MarkGilliland/benchBuddy/README.md

# benchBuddy
Code, schematics, and board layouts for the benchBuddy concept.

The benchBuddy is an adjustable power supply, DAQ unit, digital I/O source, and function generator! Just the thing for your workbench - your new buddy

Mark Gilliland 2019
