MarkGilliland/benchBuddy/eagle/facelate.pdf

GND | GND 3.3V | 5V | 0-10V 12V | FGEN
3.3V | 5V | 12V
VOLT | AMP
- | + | - | + VOLTS | AMPS | SET | ACTUAL METER USB | MANUAL | 0⁻10V | GNDON | OFF

0V

10V | 1.0A

0.0A
