MarkGilliland/benchBuddy/eagle/vectorCut.pdf

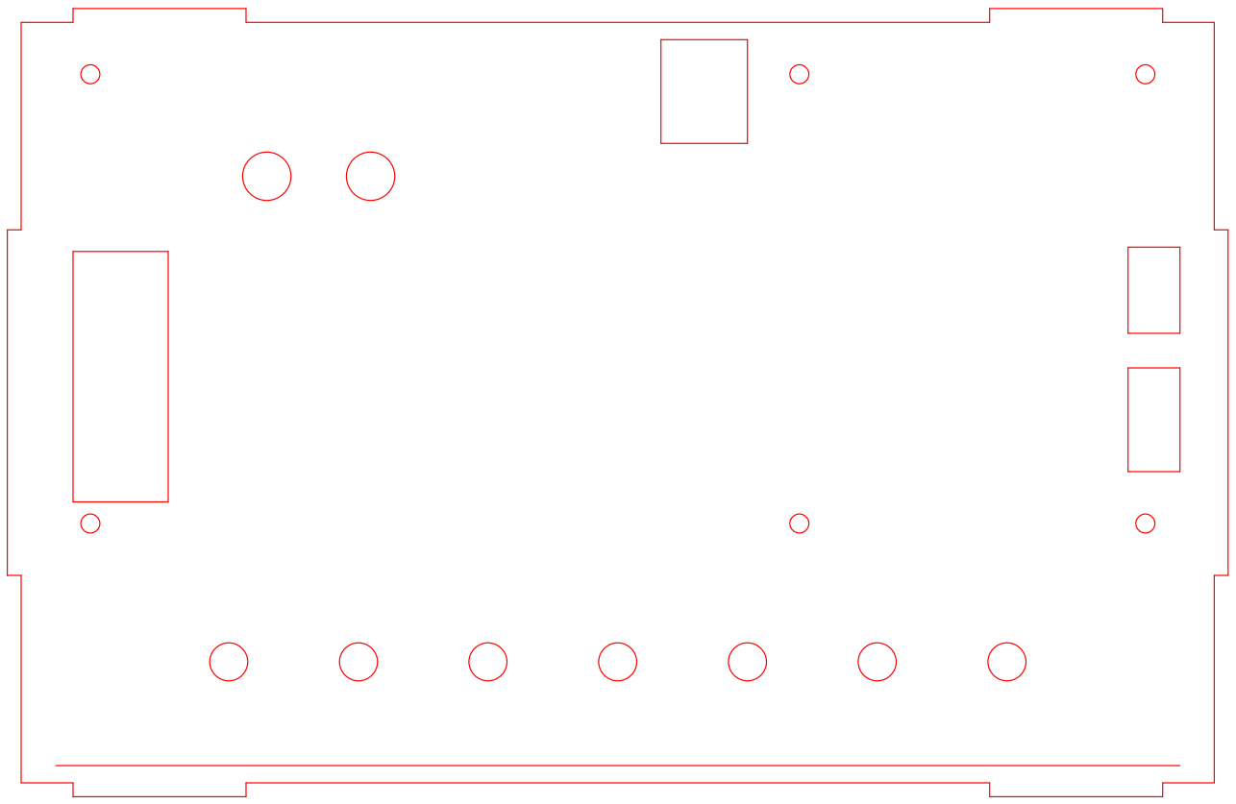
[picture p1: figure]
