MarkGilliland/benchBuddy/eagle/powerSupplyBoard.png

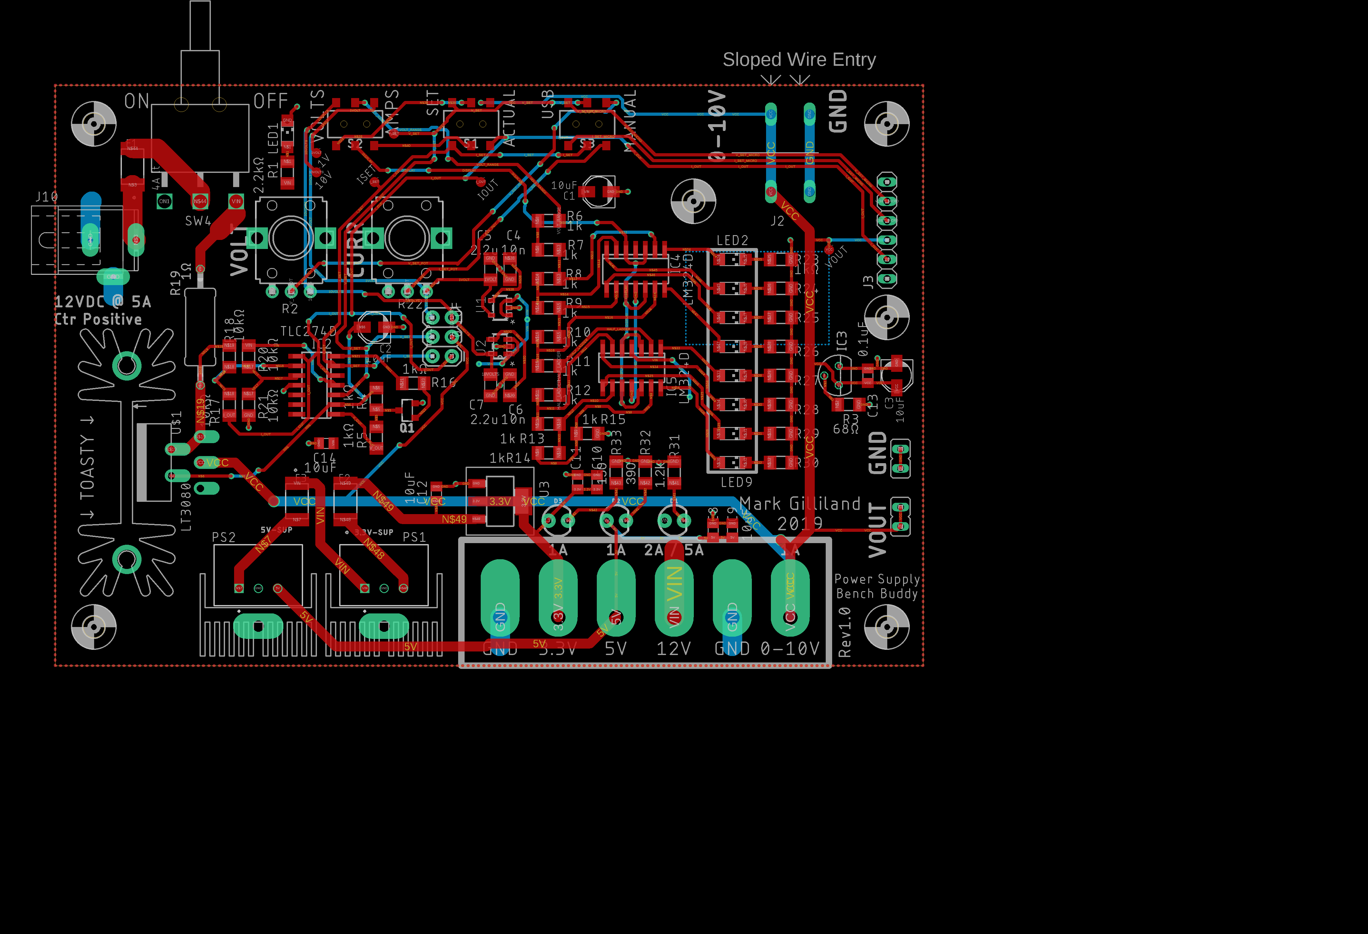
eagle/powerSupplyBoard.png
