MarkGilliland/benchBuddy/mating_header.png

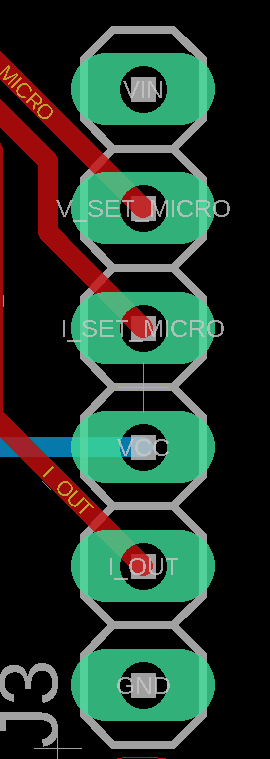
mating_header.png
