MarkGilliland/benchBuddy/microBackpack/microBackpack.png

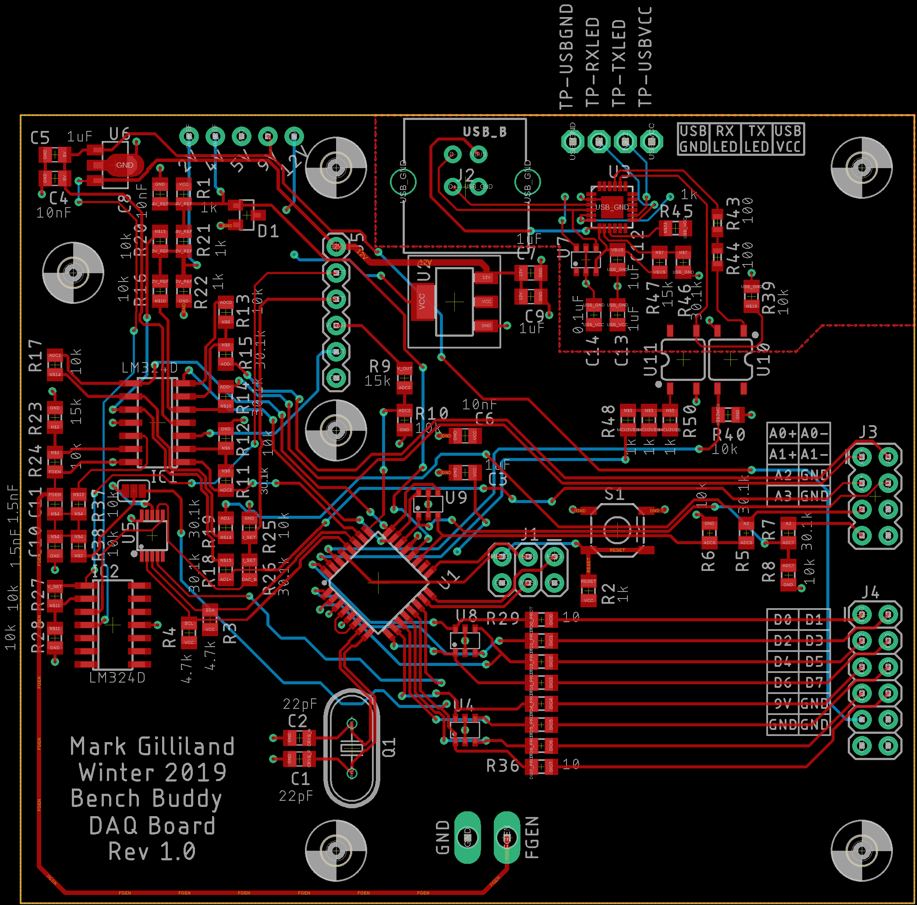
microBackpack/microBackpack.png
