MarkGilliland/benchBuddy/BOM_Initial.xlsx

Sheet: PurchaseBOM
Usage | Component Type | RefDes | Value | Package | Description | Part Number 1 | Part Number 2 | Link | Qty Required | Order Qty | Price Per | Price | Board | Part List
Crystal Capacitors | Passive, Capacitor | C1, C2 | 22pF | C0805 | CAP CER 22PF 16V C0G/NP0 0805 | 732-7816-1-ND |  | 732-7816-1-ND | 2 | 10 | $0.04 | $0.09 | MBP | MBP-C1, C2
FGen Filter Caps | Passive, Capacitor | C10, C11 | 1.5nF | C0805 | CAP CER 1500PF 25V NP0 0805 | 732-12256-1-ND |  | 732-12256-1-ND | 2 | 2 | $0.10 | $0.20 | MBP | MBP-C10, C11
Power Filter Caps | Passive, Capacitor | C3, C5, C7, C9 | 1uF | C0805 |  | 1276-6471-1-ND |  | 1276-6471-1-ND | 4 | 10 | $0.05 | $0.19 | MBP | MBP-C3, C5, C7, C9
Power Filter Caps | Passive, Capacitor | C4, C6, C8 | 10nF | C0805 |  | ‎732-8074-1-ND‎ |  | ‎732-8074-1-ND‎ | 3 | 10 | $0.03 | $0.10 | MBP | MBP-C4, C6, C8
Filter Cap, HF | Passive, Capacitor | C8, C11, C13 | 0.1uF | C0805 |  | 1276-1007-1-ND |  | 1276-1007-1-ND | 3 | 10 | $0.04 | $0.12 | PSB | PSB-C8, C11, C13
Filter Cap, LF | Passive, Capacitor | C9, C10, C12, C14 | 10uF | C0805 |  | 1276-6455-1-ND |  | 1276-6455-1-ND | 4 | 10 | $0.11 | $0.43 | PSB | PSB-C9, C10, C12, C14
Voltage Reference | Diode | D1 | SOT-23-3 |  |  | 576-1048-1-ND |  | 576-1048-1-ND | 1 | 1 | $0.29 | $0.29 | MBP | MBP-D1
4A Fuse for 12V | Fuse, PTC | F1 |  | F1812 | PTC RESET FUSE 16V 2.6A 1812 | 507-1780-1-ND |  | 507-1780-1-ND | 1 | 2 | $0.28 | $0.28 | PSB | PSB-F1
750mA Fuse for 3.3 and 5V | Fuse, PTC | F2, F3 |  | F1812 | PTC RESET FUSE 16V 500MA 1812 | 507-1761-1-ND |  | 507-1761-1-ND | 2 | 3 | $0.14 | $0.28 | PSB | PSB-F2, F3
1A Fuse for 3.3 and 5V, alternate part | Fuse, PTC | F2, F3 |  | F1812 | PTC RESET FUSE 16V 750MA 1812 | 507-1763-1-ND |  | 507-1763-1-ND | 2 | 3 | $0.14 | $0.28 | PSB | PSB-F2, F3
Op Amp for AINs | IC, Linear | IC1, IC2 | SO14 |  |  | LM324DR2GOSCT-ND |  | LM324DR2GOSCT-ND | 2 | 2 | $0.35 | $0.70 | MBP | MBP-IC1, IC2
ICSP Header | Header | J1 |  |  | 2x3 0.1" header, for flashing the bootloader to the atmega | 2057-PH2-06-UA-ND |  | 2057-PH2-06-UA-ND | 1 | 1 | $0.12 | $0.12 | MBP | MBP-J1
USB Port | Header | J2 |  |  | USB TYPE B, RIGHT ANGLE, WHITE C | 2057-USB-B-S-RA-WT-SPCC-ND |  | 2057-USB-B-S-RA-WT-SPCC-ND | 1 | 1 | $0.45 | $0.45 | MBP | MBP-J2
USB Port, Vertical | Header | J2 |  |  | CONN RCPT USB2.0 TYPEB 4POS VERT | 102-4000-ND |  | 102-4000-ND | 1 | 1 | $0.75 | $0.75 | MBP | MBP-J2
Expansion Header, Male | Header | J3 |  | 1x6x0.1" |  | 2057-PH1-06-UA-ND |  | 2057-PH1-06-UA-ND | 1 | 1 | $0.12 | $0.12 | PSB | PSB-J3
Output Header, DIO | Header | J4, J3 |  |  | 6x2 header, 0.1", for digitals | 2057-PH2-12-UA-ND |  | 2057-PH2-12-UA-ND | 2 | 2 | $0.18 | $0.36 | MBP | MBP-J4, J3
Expansion Header, Female | Header | J5 |  | 1x6x0.1" |  | S7039-ND |  | S7039-ND | 1 | 1 | $0.53 | $0.53 | MBP | MBP-J5
UART Optoisolator | IC, Logic | NA | 6-SOIC |  |  | TLP185(GB-TPLSECT-ND |  | TLP185(GB-TPLSECT-ND | 2 | 2 | $0.42 | $0.84 | MBP | MBP-NA
5W 5V Switch Mode Reg | IC, DCDC Converter | PS1, PS2 |  | 3-SIP Module | 5V 1.0A DC-DC NON-ISOLATED | 102-5018-ND |  | 102-5018-ND | 2 | 2 | $2.96 | $5.92 | PSB | PSB-PS1, PS2
Crystal Oscillator | Crystal | Q1 |  | HC-49 | 16MHz | 887-2015-ND |  | 887-2015-ND | 1 | 1 | $0.30 | $0.30 | MBP | MBP-Q1
Vref Resistor | Passive, Resistor | R1, R2, R21, R22 | 1k | R0805 | RES 1K OHM 1% 1/8W 0805 | RMCF0805FT1K00CT-ND |  | RMCF0805FT1K00CT-ND | 4 | 10 | $0.03 | $0.11 | MBP | MBP-R1, R2, R21, R22
DIO Protection resistors | Passive, Resistor | R29, R30, R31, R32, R33, R34, R35, R36 | 10 | R0805 | RES SMD 10 OHM 5% 1/8W 0805 | CR0805-JW-100ELFCT-ND |  | CR0805-JW-100ELFCT-ND | 8 | 10 | $0.02 | $0.14 | MBP | MBP-R29, R30, R31, R32, R33, R34, R35, R36
I2C Pull-ups | Passive, Resistor | R3, R4 | 4.7k | R0805 | RES SMD 4.7K OHM 5% 1/8W 0805 | CR0805-JW-472ELFCT-ND |  | CR0805-JW-472ELFCT-ND | 2 | 10 | $0.02 | $0.04 | MBP | MBP-R3, R4
12V LED Resistor | Passive, Resistor | R31 | 1.2k | R1206 | RES 1.2K OHM 5% 1/4W 1206 | RMCF1206JT1K20CT-ND |  | RMCF1206JT1K20CT-ND | 1 | 1 | $0.10 | $0.10 | PSB | PSB-R31
5V LED Resistor | Passive, Resistor | R32 | 390Ω | R1206 | RES 390 OHM 5% 1/4W 1206 | RMCF1206JT390RCT-ND |  | RMCF1206JT390RCT-ND | 1 | 1 | $0.10 | $0.10 | PSB | PSB-R32
3.3V LED Resistor | Passive, Resistor | R33 | 150Ω | R1206 | RES 150 OHM 5% 1/4W 1206 | RMCF1206JT150RCT-ND |  | RMCF1206JT150RCT-ND | 1 | 1 | $0.10 | $0.10 | PSB | PSB-R33
Amp Resistors | Passive, Resistor | R5, R7, R11, R14, R15, R18, R19, R26 | 30.1k 1% | R0805 | RES 30.1K OHM 1% 1/8W 0805 | RMCF0805FT30K1CT-ND |  | RMCF0805FT30K1CT-ND | 8 | 10 | $0.03 | $0.22 | MBP | MBP-R5, R7, R11, R14, R15, R18, R19, R26
Amp Resistors | Passive, Resistor | R6, R8, R10, R12, R13, R16, R17, R20, R24, R25, R27, R28, R37, R38 | 10k 1% | R0805 | RES 10K OHM 1% 1/8W 0805 | RMCF0805FT10K0CT-ND |  | RMCF0805FT10K0CT-ND | 14 | 100 | $0.03 | $0.38 | MBP | MBP-R6, R8, R10, R12, R13, R16, R17, R20, R24, R25, R27, R28, R37, R38
Amp Resistors | Passive, Resistor | R9, R23 | 15k 1% | R0805 | RES 15K OHM 1% 1/8W 0805 | RMCF0805FT15K0CT-ND |  | RMCF0805FT15K0CT-ND | 2 | 10 | $0.03 | $0.05 | MBP | MBP-R9, R23
Reset button | Button | S1 |  | 5.2mm sqaure | TACT 5.2 X 5.2, 1.5 MM H, 160GF, | CKN12220-1-ND |  | CKN12220-1-ND | 1 | 1 | $0.10 | $0.10 | MBP | MBP-S1
Selection Switch | Switch | S3 |  |  | Made to match ones from class | 401-2001-ND |  | 401-2001-ND | 1 | 1 | $0.43 | $0.43 | PSB | PSB-S3
Microcontroller, Arduino | IC, Logic | U1 |  | 32-TQFP |  | ATMEGA328PB-AURCT-ND | ATMega328P | ATMEGA328PB-AURCT-ND | 1 | 1 | $1.42 | $1.42 | MBP | MBP-U1
5V Supply | IC, Linear | U2 |  | SOT223 | IC REG LINEAR 5V 800MA SOT223 | AZ1117IH-5.0TRG1DICT-ND |  | AZ1117IH-5.0TRG1DICT-ND | 1 | 3 | $0.36 | $0.36 | MBP | MBP-U2
1A 3.3V Linear Reg | IC, Volt Reg | U3 |  | SOT223 | IC REG LINEAR 3.3V 1A SOT223 | AP2114HA-3.3TRG1DICT-ND |  | AP2114HA-3.3TRG1DICT-ND | 1 | 3 | $0.36 | $0.36 | PSB | PSB-U3
USB to UART Adapter | IC, Logic | U3 |  |  | CP2102N-A02-GQFN24R | 336-5888-1-ND |  | 336-5888-1-ND | 1 | 1 | $1.35 | $1.35 | MBP | MBP-U3
5V/AIN/USB protection diodes | Diode | U4, U7, U8, U9 |  |  |  | 1727-1582-1-ND |  | 1727-1582-1-ND | 4 | 5 | $0.31 | $1.24 | MBP | MBP-U4, U7, U8, U9
Op Amp Power Supply | IC, Linear | U6 | SOT89-3 |  | IC REG LINEAR 9V 100MA SOT89-3 | 497-1192-1-ND | L78L09ACUTR | 497-1192-1-ND | 1 | 1 | $0.40 | $0.40 | MBP | MBP-U6
 |  |  |  |  |  |  |  |  |  |  | Total: | $19.24

Sheet: Main Board Additions
Source | Usage | Component Type | RefDes | Value | Package | Description | Part Number 1 | Part Number 2 | Link | Qty | Price Per | Price | Notes | Eagle Footprint
 | 1A 3.3V Linear Reg | IC, Volt Reg | U3 |  | SOT223 | IC REG LINEAR 3.3V 1A SOT223 | AP2114HA-3.3TRG1DICT-ND |  | AP2114HA-3.3TRG1DICT-ND | 1 | $0.36 | $0.36 |  | Custom
 | 5W 5V Switch Mode Reg | DCDC Converter | PS1, PS2 |  | 3-SIP Module | 5V 1.0A DC-DC NON-ISOLATED | 102-5018-ND |  | 102-5018-ND | 2 | $2.96 | $5.92 |  | Imported Unchecked
 | 750mA Fuse for 3.3 and 5V | Fuse, PTC | F2, F3 |  | F1812 | PTC RESET FUSE 16V 500MA 1812 | 507-1761-1-ND |  | 507-1761-1-ND | 3 | $0.14 | $0.42 |  | Imported Unchecked
 | 1A Fuse for 3.3 and 5V, alternate part | Fuse, PTC | F2, F3 |  | F1812 | PTC RESET FUSE 16V 750MA 1812 | 507-1763-1-ND |  | 507-1763-1-ND | 3 | $0.14 | $0.42 |  | Imported Unchecked
 | 4A Fuse for 12V | Fuse, PTC | F1 |  | F1812 | PTC RESET FUSE 16V 2.6A 1812 | 507-1780-1-ND |  | 507-1780-1-ND | 2 | $0.28 | $0.56 |  | Imported Unchecked
 | 3.3V LED Resistor | Resistor | R33 | 150Ω | R1206 | RES 150 OHM 5% 1/4W 1206 | RMCF1206JT150RCT-ND |  | RMCF1206JT150RCT-ND | 1 | $0.03 | $0.03 |  | Built-In
 | 5V LED Resistor | Resistor | R32 | 390Ω | R1206 | RES 390 OHM 5% 1/4W 1206 | RMCF1206JT390RCT-ND |  | RMCF1206JT390RCT-ND | 1 | $0.03 | $0.03 |  | Built-In
 | 12V LED Resistor | Resistor | R31 | 1.2k | R1206 | RES 1.2K OHM 5% 1/4W 1206 | RMCF1206JT1K20CT-ND |  | RMCF1206JT1K20CT-ND | 1 | $0.03 | $0.03 |  | Built-In
 | Indicator LED | Diode, LED | D1, D2, D3 |  | 3mm LED | Any color LED |  |  | 0 | 3 | $0.00 | $0.00 | Have | Built-In
 | Filter Cap, HF | Capacitor | C8, C11, C13 | 0.1uF | C0805 | From Motor Driver BOM | 1276-1007-1-ND |  | 1276-1007-1-ND | 3 | $0.00 | $0.00 | Have | Built-In
 | Filter Cap, LF | Capacitor | C9, C10, C12, C14 | 10uF | C0805 | From Motor Driver BOM | 587-2985-1-ND |  | 587-2985-1-ND | 4 | $0.00 | $0.00 | Have | Built-In
 | Selection Switch |  | S3 |  |  |  | 401-2001-ND |  | 401-2001-ND |  |  | $0.00
 | Expansion Header |  | J3 |  | 1x6x0.1" |  | 2057-PH1-06-UA-ND |  | 2057-PH1-06-UA-ND |  |  | $0.00
 |  |  |  |  |  |  |  |  | 0 |  |  | $0.00
 |  |  |  |  |  |  |  |  | 0 |  |  | $0.00
 |  |  |  |  |  |  |  |  | 0 |  |  | $0.00
 |  |  |  |  |  |  |  |  | 0 |  |  | $0.00
 |  |  |  |  |  |  |  |  | 0 |  |  | $0.00
 |  |  |  |  |  |  |  |  | 0 |  |  | $0.00
 |  |  |  |  |  |  |  |  | 0 |  |  | $0.00
 |  |  |  |  |  |  |  |  | 0 |  |  | $0.00
 |  |  |  |  |  |  |  |  | 0 |  |  | $0.00
 |  |  |  |  |  |  |  |  | 0 |  |  | $0.00
 |  |  |  |  |  |  |  |  | 0 |  |  | $0.00
 |  |  |  |  |  |  |  |  | 0 |  |  | $0.00
 |  |  |  |  |  |  |  |  | 0 |  |  | $0.00
 |  |  |  |  |  |  |  |  | 0 |  |  | $0.00
 |  |  |  |  |  |  |  |  | 0 |  |  | $0.00
 |  |  |  |  |  |  |  |  | 0 |  |  | $0.00
 |  |  |  |  |  |  |  |  | 0 |  |  | $0.00
 |  |  |  |  |  |  |  |  | 0 |  |  | $0.00
 |  |  |  |  |  |  |  |  | 0 |  |  | $0.00
 |  |  |  |  |  |  |  |  |  |  | Total | $7.76

Sheet: MCU Board
Usage | Component Type | RefDes | Value | Package | Description | Part Number 1 | Part Number 2 | Link | Qty | Price Per | Price | Notes | Eagle Footprint
Crystal Capacitors | Capacitor | C1, C2 | 22pF | C0805 | CAP CER 22PF 16V C0G/NP0 0805 | 732-7816-1-ND |  | 732-7816-1-ND | 2 | $0.04 | $0.09 |  | Built-In
FGen Filter Caps | Capacitor | C10, C11 | 1.5nF | C0805 | CAP CER 1500PF 25V NP0 0805 | 732-12256-1-ND |  | 732-12256-1-ND | 2 | $0.10 | $0.20
Power Filter Caps | Capacitor | C3, C5, C7, C9 | 1uF | C0805 |  | 1276-6471-1-ND |  | 1276-6471-1-ND | 4 | $0.05 | $0.19
Power Filter Caps | Capacitor | C4, C6, C8 | 10nF | C0805 |  | 1276-6455-1-ND |  | 1276-6455-1-ND | 3 | $0.11 | $0.32
Voltage Reference | Diode | D1 | SOT-23-3 |  |  | 576-1048-1-ND |  | 576-1048-1-ND | 1 | $0.29 | $0.29 |  | Custom
Op Amp for AINs | IC, Linear | IC1, IC2 | SO14 |  |  | LM324DR2GOSCT-ND |  | LM324DR2GOSCT-ND | 2 | $0.35 | $0.70 |  | Built-In
ICSP Header |  | J1 |  |  | 2x3 0.1" header, for flashing the bootloader to the atmega | 2057-PH2-06-UA-ND |  | 2057-PH2-06-UA-ND | 1 | $0.12 | $0.12
USB Port, Vertical |  | J2 |  |  | CONN RCPT USB2.0 TYPEB 4POS VERT | 102-4000-ND |  | 102-4000-ND | 1 | $0.75 | $0.75
USB Port |  | J2 |  |  | USB TYPE B, RIGHT ANGLE, WHITE C | 2057-USB-B-S-RA-WT-SPCC-ND |  | 2057-USB-B-S-RA-WT-SPCC-ND | 1 | $0.45 | $0.45
Output Header, AIN |  | J3 |  |  | 4x2 header, 0.1", for analogs (Cut from larger | 2057-PH2-12-UA-ND |  | 2057-PH2-12-UA-ND | 1 | $0.00 | $0.00
Output Header, DIO |  | J4, J3 |  |  | 6x2 header, 0.1", for digitals | 2057-PH2-12-UA-ND |  | 2057-PH2-12-UA-ND | 1 | $0.18 | $0.18
Expansion Header, Female |  | J5 |  | 1x6x0.1" |  | S7039-ND |  | S7039-ND | 1 | $0.53 | $0.53
UART Optoisolator | IC, Logic | NA | 6-SOIC |  |  | TLP185(GB-TPLSECT-ND |  | TLP185(GB-TPLSECT-ND | 2 | $0.42 | $0.84
Crystal Oscillator | Crystal | Q1 |  | HC-49 | 16MHz | 887-2015-ND |  | 887-2015-ND | 1 | $0.30 | $0.30 |  | Built-In
Vref Resistor | Resistor | R1, R2, R21, R22 | 1k | R0805 | RES 1K OHM 1% 1/8W 0805 | RMCF0805FT1K00CT-ND |  | RMCF0805FT1K00CT-ND | 4 | $0.03 | $0.11
DIO Protection resistors | Resistor | R29, R30, R31, R32, R33, R34, R35, R36 | 10 | R0805 | RES SMD 10 OHM 5% 1/8W 0805 | CR0805-JW-100ELFCT-ND |  | CR0805-JW-100ELFCT-ND | 8 | $0.02 | $0.14
I2C Pull-ups | Resistor | R3, R4 | 4.7k | R0805 | RES SMD 4.7K OHM 5% 1/8W 0805 | CR0805-JW-472ELFCT-ND |  | CR0805-JW-472ELFCT-ND | 2 | $0.02 | $0.04
Amp Resistors | Resistor | R5, R7, R11, R14, R15, R18, R19, R26 | 30.1k 1% | R0805 | RES 30.1K OHM 1% 1/8W 0805 | RMCF0805FT30K1CT-ND |  | RMCF0805FT30K1CT-ND | 8 | $0.03 | $0.22
Amp Resistors | Resistor | R6, R8, R10, R12, R13, R16, R17, R20, R24, R25, R27, R28, R37, R38 | 10k 1% | R0805 | RES 10K OHM 1% 1/8W 0805 | RMCF0805FT10K0CT-ND |  | RMCF0805FT10K0CT-ND | 14 | $0.03 | $0.38
Amp Resistors | Resistor | R9, R23 | 15k 1% | R0805 | RES 15K OHM 1% 1/8W 0805 | RMCF0805FT15K0CT-ND |  | RMCF0805FT15K0CT-ND | 2 | $0.03 | $0.05
Reset button | Button | S1 |  | 5.2mm sqaure | TACT 5.2 X 5.2, 1.5 MM H, 160GF, | CKN12220-1-ND |  | CKN12220-1-ND | 1 | $0.10 | $0.10
Microcontroller, Arduino | IC, Logic | U1 |  | 32-TQFP |  | ATMEGA328PB-AURCT-ND | ATMega328P | ATMEGA328PB-AURCT-ND | 1 | $1.42 | $1.42 |  | Built-In | Verify same as USB Motor Driver
5V Supply | IC, Linear | U2 |  | SOT223 | IC REG LINEAR 5V 800MA SOT223 | AZ1117IH-5.0TRG1DICT-ND |  | AZ1117IH-5.0TRG1DICT-ND | 1 | $0.36 | $0.36 |  | Custom
USB to UART Adapter | IC, Logic | U3 |  |  | IC USB TO UART BRIDGE QFN24 | 336-5888-1-ND |  | 336-5888-1-ND | 1 | $1.35 | $1.35 |  | Custom
5V/AIN/USB protection diodes | Diode | U4, U7, U8, U9 |  |  |  | 1727-1582-1-ND |  | 1727-1582-1-ND | 4 | $0.31 | $1.24 |  | Custom
DAC Chip | IC, Linear | U5 | 10-MSOP |  |  | MCP4728-E/UN-ND |  | MCP4728-E/UN-ND | 1 | $0.00 | $0.00 |  | Custom
Op Amp Power Supply | IC, Linear | U6 | SOT89-3 |  | IC REG LINEAR 9V 100MA SOT89-3 | 497-1192-1-ND | L78L09ACUTR | 497-1192-1-ND | 1 | $0.40 | $0.40 |  | Built-In
 |  |  |  |  |  |  |  | 0 |  |  | $0.00
 |  |  |  |  |  |  |  | 0 |  |  | $0.00
 |  |  |  |  |  |  |  | 0 |  |  | $0.00
 |  |  |  |  |  |  |  | 0 |  |  | $0.00
 |  |  |  |  |  |  |  | 0 |  |  | $0.00
 |  |  |  |  |  |  |  | 0 |  |  | $0.00
 |  |  |  |  |  |  |  |  |  | Total | $10.76

Sheet: microBackpack_BOM
Qty | Value | Device | Package | Parts | Description
2 | 22pF | C-USC0805 | C0805 | C1, C2 | CAPACITOR, American symbol
2 | 1.5nF | C-USC0805 | C0805 | C10, C11 | CAPACITOR, American symbol
4 | 1uF | C-USC0805 | C0805 | C3, C5, C7, C9 | CAPACITOR, American symbol
3 | 10nF | C-USC0805 | C0805 | C4, C6, C8 | CAPACITOR, American symbol
1 | LM4040-V-REF | LM4040-V-REF | SOT23 | D1 | LM4040DYM3-4.1-TR from Microchip, 4.096V vref diode
2 | LM324D | LM324D | SO14 | IC1, IC2 | OP AMP
1 |  | CONN_03X22X3_SILK_MALE_PTH | 2X3 | J1 | Multi connection point. Often used as Generic Header-pin footprint for 0.1 inch spaced/style header connections
1 | USB_B_PTH | USB_B_PTH | USB-B-PTH | J2 | USB Type B Connector
1 |  | CONN_04X2 | 2X4 | J3 | Multi connection point. Often used as Generic Header-pin footprint for 0.1 inch spaced/style header connections
1 | 2X6 FEMALE | CONN_06X2PTH_FEMALE | 2X6 | J4 | Multi connection point. Often used as Generic Header-pin footprint for 0.1 inch spaced/style header connections
1 |  | CONN_06SILK_FEMALE_PTH | 1X06 | J5 | Multi connection point. Often used as Generic Header-pin footprint for 0.1 inch spaced/style header connections
1 |  | CRYSTALHC49U70 | HC49U70 | Q1 | CRYSTAL
4 | 1k | R-US_R0805 | R0805 | R1, R2, R21, R22 | RESISTOR, American symbol
8 | 10 | R-US_R0805 | R0805 | R29, R30, R31, R32, R33, R34, R35, R36 | RESISTOR, American symbol
2 | 4.7k | R-US_R0805 | R0805 | R3, R4 | RESISTOR, American symbol
8 | 30.1k | R-US_R0805 | R0805 | R5, R7, R11, R14, R15, R18, R19, R26 | RESISTOR, American symbol
14 | 10k | R-US_R0805 | R0805 | R6, R8, R10, R12, R13, R16, R17, R20, R24, R25, R27, R28, R37, R38 | RESISTOR, American symbol
2 | 15k | R-US_R0805 | R0805 | R9, R23 | RESISTOR, American symbol
1 | MOMENTARY-SWITCH-SPST-SMD-5.2-REDUNDANT | MOMENTARY-SWITCH-SPST-SMD-5.2-REDUNDANT | TACTILE_SWITCH_SMD_5.2MM | S1 | Momentary Switch (Pushbutton) - SPST
1 | ATMEGA328P_TQFP | ATMEGA328P_TQFP | TQFP32-08 | U1 | Popular 328P in QFP
1 | 5VREG-HS | 5VREG-HS | SOT223-HS | U2 | Diodes Inc. 800mA 3.3V cheap VREG
1 | CP2102N-QFN24 | CP2102N-QFN24 | QFN-24_ALT2 | U3
4 | TVS_DIODE_4PK | TVS_DIODE_4PK | SOT457 | U4, U7, U8, U9
1 | MCP4728 | MCP4728 | MSOP10 | U5 | MCP4728-E/UN 12-bit DAC chip on MSOP-10 package. Digital to Analog conversion, high speed
1 | 78L09F | 78L09F | SOT89 | U6 | POSITOIV-VOLTAGE REGULATORS

Sheet: benchBuddyPSB_BOM
Source | Qty | Value | Device | Package | Parts | Description
Class | 3 | 10uF | CPOL-USB | PANASONIC_B | C1, C2, C3 | POLARIZED CAPACITOR, American symbol
Class | 2 | 10n | C-USC1206 | C1206 | C4, C6 | CAPACITOR, American symbol
Class | 2 | 2.2u | C-USC1206 | C1206 | C5, C7 | CAPACITOR, American symbol
Class | 1 | TLC274D | TLC274D | SO14 | IC2 | OP AMP
Class | 1 | LM334Z | LM334Z | TO92 | IC3 | 3-Terminal Adjustable Current Sources
Class | 2 | LM324D | LM324D | SO14 | IC4, IC5 | OP AMP
Class | 1 | 12V_DC | POWER_JACKSLT | POWER_JACK_SLOT | J1 | Power Jack Connector
Class | 1 |  | PHOENIX_SPRING_TERM_2POS | SPRING_TERM_2POS | J2
Class | 2 |  | JP1E | JP1 | JP1, JP2 | JUMPER
Class | 1 | SK104-PAD | SK104-PAD | SK104-PAD | KK1 | HEATSINK manufacturer Fischer/distributor Buerklin
Class | 9 |  | LEDCHIPLED_1206 | CHIPLED_1206 | LED1, LED2, LED3, LED4, LED5, LED6, LED7, LED8, LED9 | LED
Class | 1 | 600mA/40V | TRANS_NPN-MMBT2222AL | SOT23-3 | Q1 | NPN transistor
Class | 1 | 2.2kÎ© | R-US_R1206 | R1206 | R1 | RESISTOR, American symbol
Class | 4 | 10kÎ© | R-US_R1206 | R1206 | R17, R18, R20, R21 | RESISTOR, American symbol
Class | 1 | 1Î© | R-US_0411/15 | 0411/15 | R19 | RESISTOR, American symbol
Class | 2 | EVUF2A | EVUF2A | EVUF | R2, R22 | 9 mm Square Rotary Potentiometers
Class | 1 | 68Î© | R-US_R1206 | R1206 | R3 | RESISTOR, American symbol
Class | 3 |  | R-US_R1206 | R1206 | R31, R32, R33 | RESISTOR, American symbol
Class | 11 | 1kÎ© | R-US_R1206 | R1206 | R4, R5, R16, R23, R24, R25, R26, R27, R28, R29, R30 | RESISTOR, American symbol
Class | 10 | 1k | R-US_R1206 | R1206 | R6, R7, R8, R9, R10, R11, R12, R13, R14, R15 | RESISTOR, American symbol
Class | 1 | EG2362 | EG2362 | SWITCH_EG2362-ND | SW4
Class | 1 | LT3080 | LT3080 | TO-220-5R | U$1
Class | 1 | LP2983AIM5-1.0/NOPBMF05A-L | LP2983AIM5-1.0/NOPBMF05A-L | MF05A-L | U1
Class | 1 | LP2985-10DBVR | LP2985-10DBVR | DBV5 | U2
Class and Extra | 3 |  | SWITCH-DPDT-SMD-AYZ0202 | SWITCH_DPDT_SMD_AYZ0202 | S1, S2, S3 | Double-Pole, Double-Throw (DPDT) Switch
Extra (Bins) | 3 |  | LED3MM | LED_3MM | D1, D2, D3 | LED (Generic)
Extra (Bins) | 1 |  | PINHD-1X6 | 1X06 | J3 | PIN HEADER
Extra (Bins) | 2 | HEATSINK_MINI | HEATSINK_MINI | HEATSINK_MINI | U$2, U$3
Extra (Buy) | 1 | 4A It | FUSE | LITTELFUSE_MINISMDC260F/12-2 | F1
Extra (Buy) | 2 | 1.5A It | FUSE | LITTELFUSE_MINISMDC260F/12-2 | F2, F3
Extra (Buy) | 2 | P78E05-1000 | P78E05-1000 | CONV_P78E05-1000 | PS1, PS2 | NON-ISOLATED DC SWITCHING REGULATOR
Extra (Buy) | 1 | 3V3REG-HEATSINK | 3V3REG-HEATSINK | SOT223-HS | U3 | Cheap 3.3V VReg, Linear SOT223, 1A
Extra (Re-use) | 3 | 0.1uF | C-USC0805 | C0805 | C8, C11, C13 | CAPACITOR, American symbol
Extra (Re-use) | 4 | 10uF | C-USC0805 | C0805 | C9, C10, C12, C14 | CAPACITOR, American symbol
