MarkGilliland/benchBuddy/eagle/benchBuddy.dxf

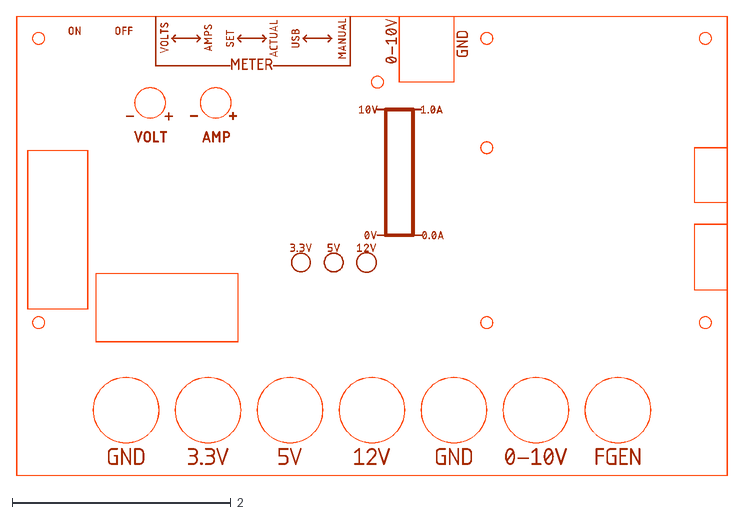
[picture p5: CAD file, 2019-11-17]
eagle/benchBuddy.dxf
6.51 x 4.21
