MarkGilliland/benchBuddy/microBackpack/microBackpack.pdf

# TVS_DIODE_4PK VCC

# GNDVCC

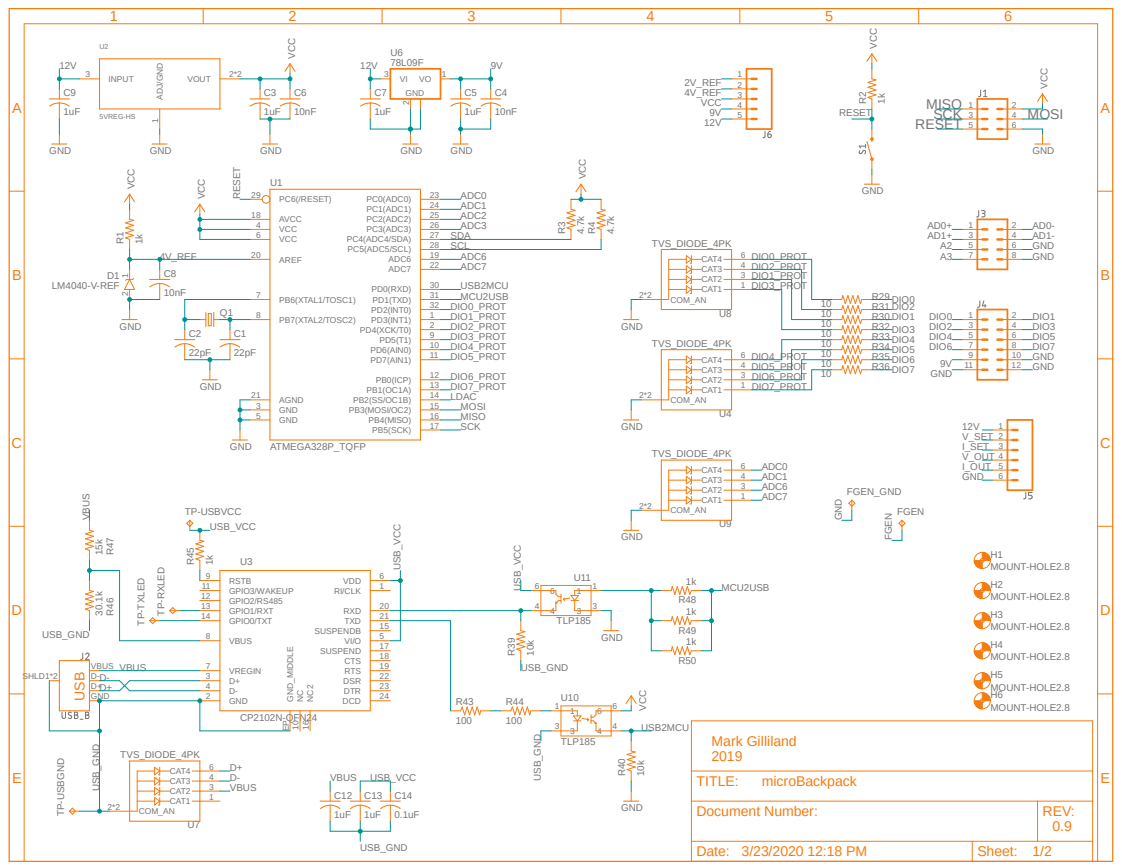
[picture p6: page 1]

1 U3 RI/CLK 1 GND 2 D+ 3 D- 4 VI/O 5 VDD 6 VREGIN 7 VBUS 8 RSTB 9 NC 10 GPIO3/WAKEUP 11 GPIO2/RS485 12 GPIO1/RXT 13 GPIO0/TXT 14 SUSPENDB 15 NC2 16 SUSPEND 17 CTS 18 RTS 19 RXD 20 TXD 21 DSR 22 DTR 23 DCD GND_MIDDLE 24 EP

GND
VBUS
TP-USBVCC R⁴⁵ R⁴⁶ R⁴⁷

REV: 0.9

Date: 3/23/2020 12:18 PM | Sheet: 1/2

## ISET div by 4 VSET mult by 2.6

# FGEN ¹²V

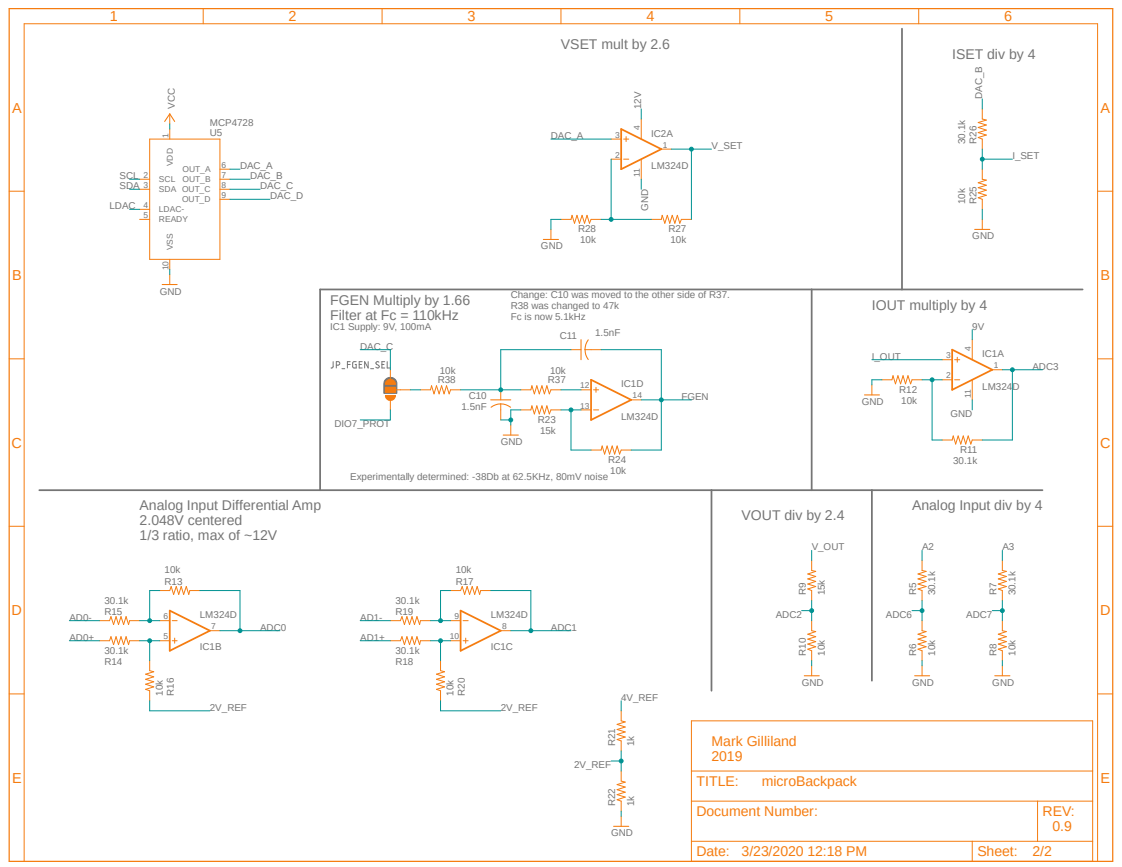
[picture p7: page 2]

Change: C10 was moved to the other side of R37.
R38 was changed to 47k
Fc is now 5.1kHz

Experimentally determined: -38Db at 62.5KHz, 80mV noise

Document Number: | REV: 0.9

Date: 3/23/2020 12:18 PM | Sheet: 2/2
