MarkGilliland/benchBuddy/pdf/benchBuddyLayout_rev1.1.pdf

## Sloped Wire Entry

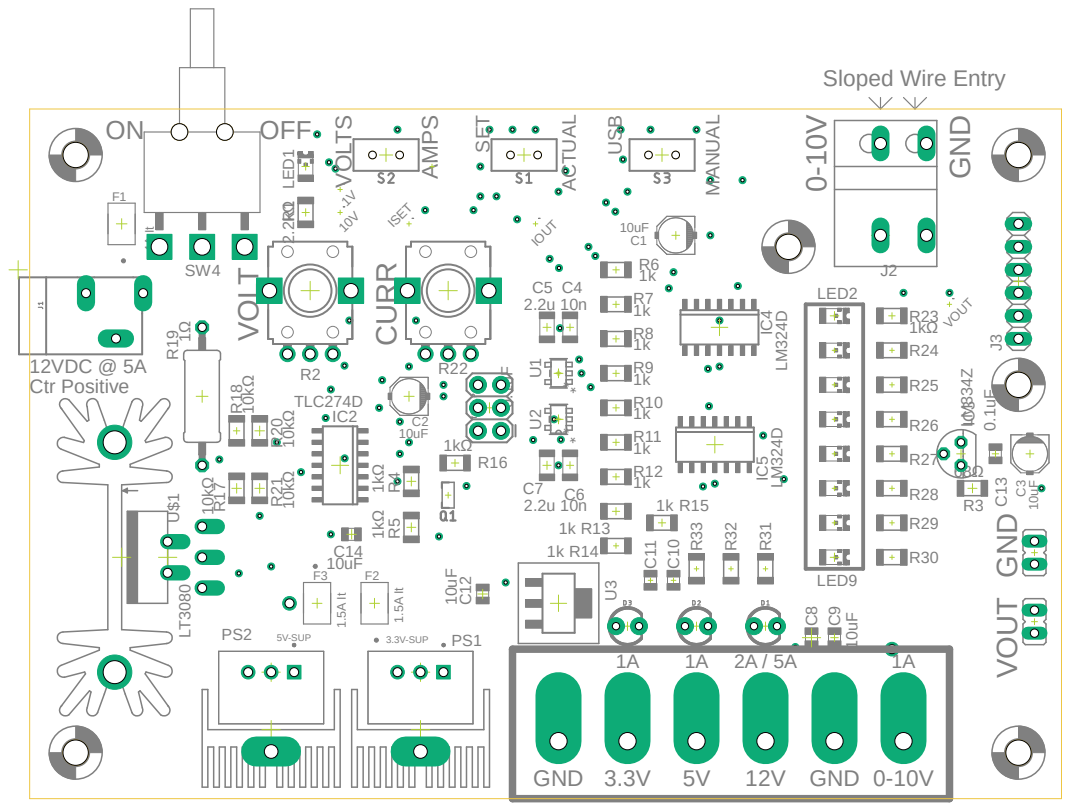
[picture p8: page 1]

IOUT VOLT CURR GND VOUT 1A 1A 2A / 5A 1A
