MarkGilliland/benchBuddy/pdf/benchBuddySchem_rev1.0.pdf

# 3.3V @ 1A Supply

A

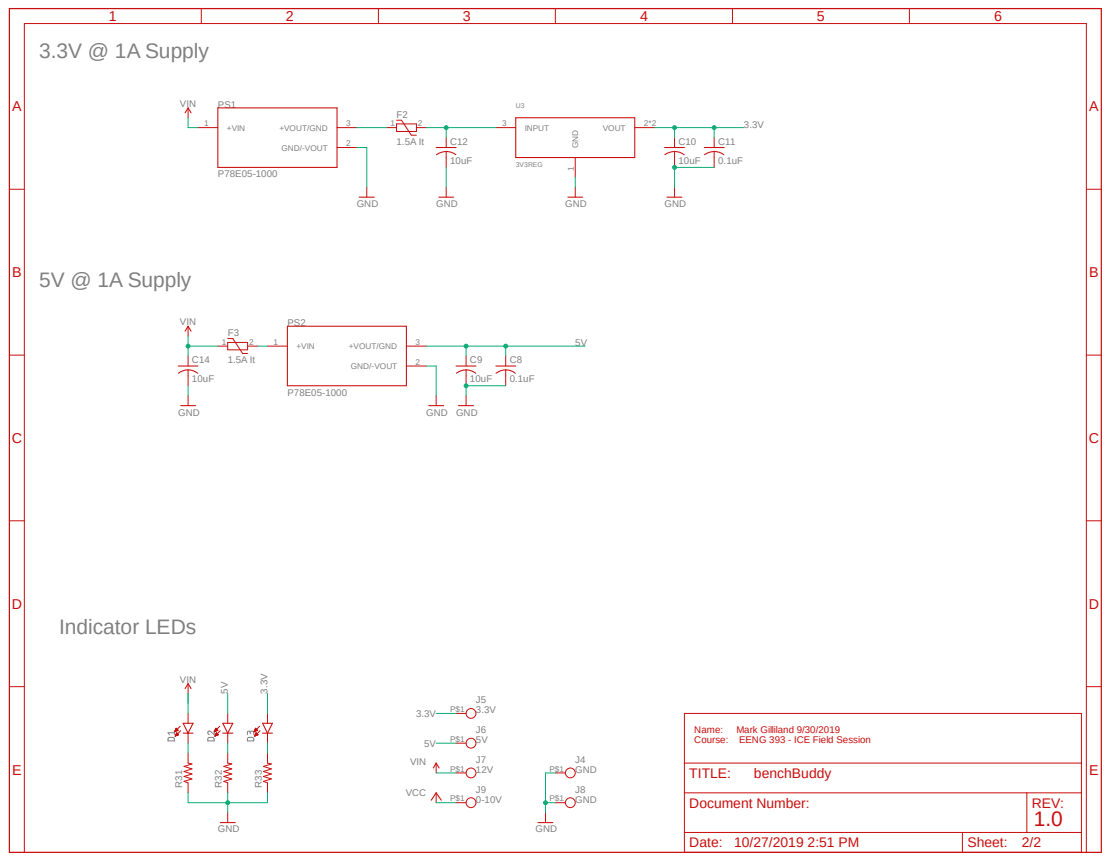
[picture p9: page 1]

Course: EENG 393 - ICE Field Session

Document Number: | REV: 1.0

Date: 10/27/2019 2:51 PM | Sheet: 2/2
