MarkGilliland/benchBuddy/microBackpack/microBackpack.brd

## EAGLE design microBackpack/microBackpack.brd (2019-11-19)

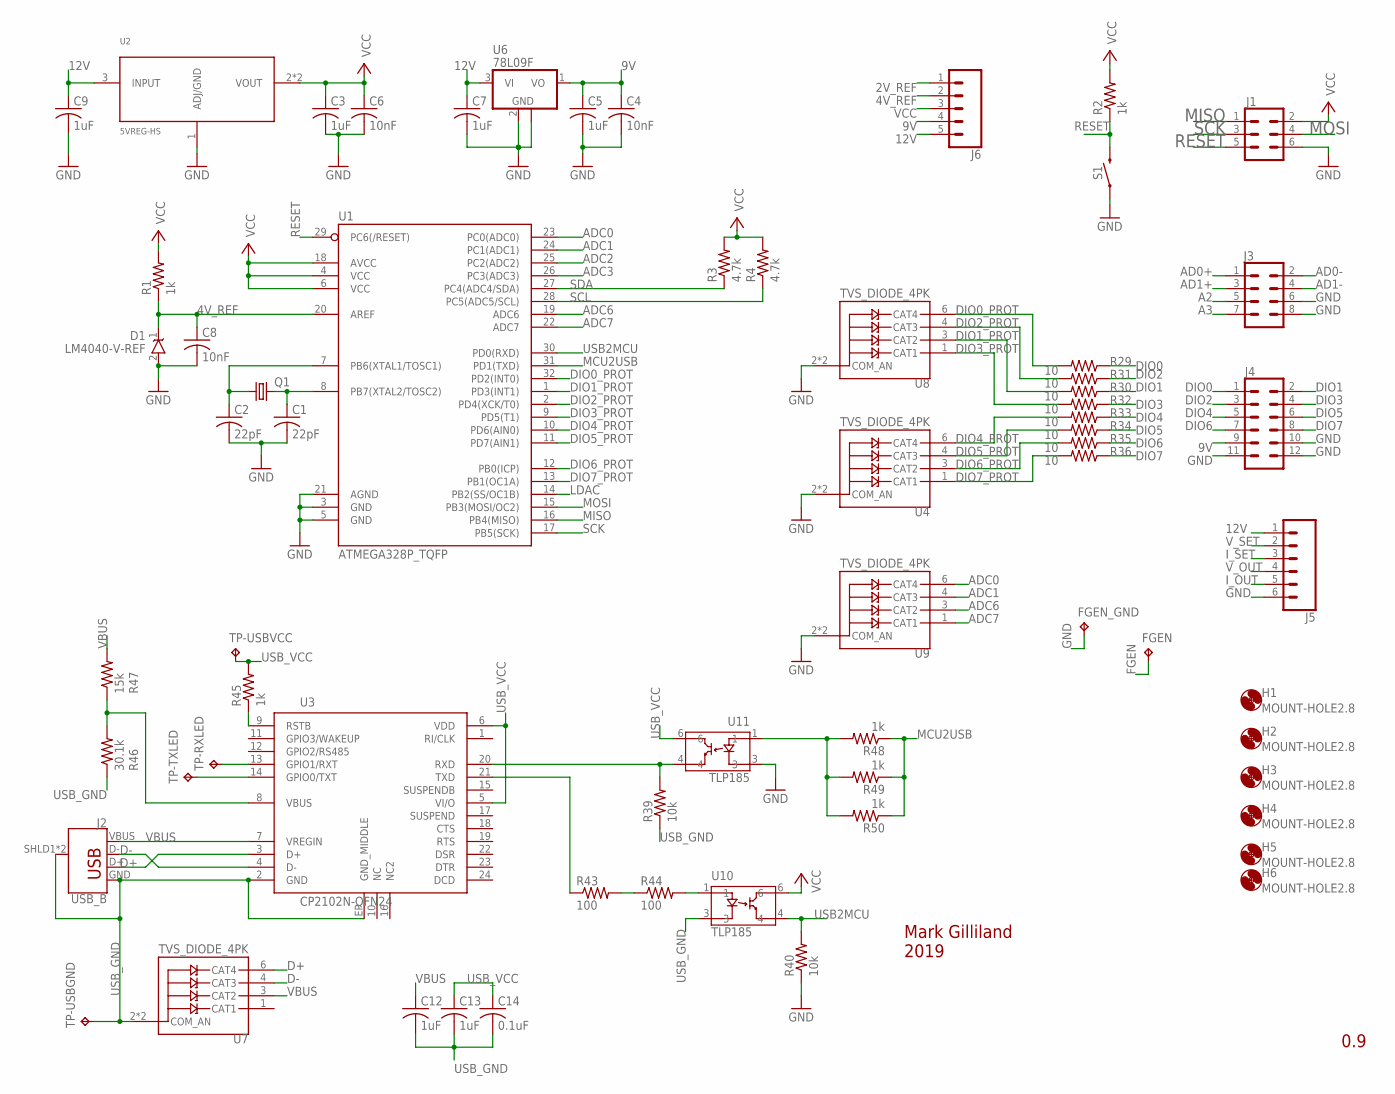
[picture p10: schematic microBackpack.sch, sheet 1]

Parts:
C1, C2: 22pF; C0805
C3, C5, C7, C9, C12, C13: 1uF; C0805
C4, C6, C8: 10nF; C0805
C14: 0.1uF; C0805
D1: LM4040-V-REF; SOT23
FGEN: TPPAD1-20Y; P1-20Y
FGEN_GND: TPPAD1-20Y; P1-20Y
H1, H2, H3, H4, H5, H6: MOUNT-HOLE2.8; 2,8
J1: CONN_03X22X3_SILK_MALE_PTH; 2X3
J2: USB_B; USB-B-PTH-VERT
J3: CONN_04X2; 2X4
J4: 2X6 FEMALE; 2X6
J5: CONN_06SILK_FEMALE_PTH; 1X06
J6: CONN_05NO_SILK; 1X05_NO_SILK
Q1: CRYSTALHC49U70; HC49U70
R1, R2, R45, R48, R49, R50: 1k; R0805
R3, R4: 4.7k; R0805
R29, R30, R31, R32, R33, R34, R35, R36: 10; R0805
R39, R40: 10k; R0805
R43, R44: 100; R0603
R46: 30.1k; R0805
R47: 15k; R0805
S1: MOMENTARY-SWITCH-SPST-SMD-5.2-REDUNDANT; TACTILE_SWITCH_SMD_5.2MM
TP-RXLED: TPPAD1-13; P1-13
TP-TXLED: TPPAD1-13; P1-13
TP-USBGND: TPPAD1-13; P1-13
TP-USBVCC: TPPAD1-13; P1-13
U1: ATMEGA328P_TQFP; TQFP32-08
U2: 5VREG-HS; SOT223-HS
U3: CP2102N-QFN24; QFN-24_ALT2
U4, U7, U8, U9: TVS_DIODE_4PK; SOT457
U6: 78L09F; SOT89
U10, U11: TLP185; SO06-4

Connections:
2V_REF: J6.1; also elsewhere on the board
4V_REF: C8.1, D1.1 (+IN), J6.2, R1.1, U1.20 (AREF); also elsewhere on the board
9V: C4.1, C5.1, J4.9, J6.4, U6.1 (VO); also elsewhere on the board
12V: C7.1, C9.1, J5.1, J6.5, U2.3 (INPUT), U6.3 (VI); also elsewhere on the board
A2: J3.5; also elsewhere on the board
A3: J3.7; also elsewhere on the board
AD0+: J3.1; also elsewhere on the board
AD0-: J3.2; also elsewhere on the board
AD1+: J3.3; also elsewhere on the board
AD1-: J3.4; also elsewhere on the board
ADC0: U1.23 (PC0(ADC0)), U9.6 (CAT4); also elsewhere on the board
ADC1: U1.24 (PC1(ADC1)), U9.4 (CAT3); also elsewhere on the board
ADC2: U1.25 (PC2(ADC2)); also elsewhere on the board
ADC3: U1.26 (PC3(ADC3)); also elsewhere on the board
ADC6: U1.19 (ADC6), U9.3 (CAT2); also elsewhere on the board
ADC7: U1.22 (ADC7), U9.1 (CAT1); also elsewhere on the board
CRYS_N: C2.1, Q1.1, U1.7 (PB6(XTAL1/TOSC1))
CRYS_P: C1.1, Q1.2, U1.8 (PB7(XTAL2/TOSC2))
D+: J2.D+, U3.3 (D+), U7.6 (CAT4)
D-: J2.D-, U3.4 (D-), U7.4 (CAT3)
DIO0: J4.1, R29.1
DIO0_PROT: R29.2, U1.32 (PD2(INT0)), U8.6 (CAT4)
DIO1: J4.2, R30.1
DIO1_PROT: R30.2, U1.1 (PD3(INT1)), U8.3 (CAT2)
DIO2: J4.3, R31.1
DIO2_PROT: R31.2, U1.2 (PD4(XCK/T0)), U8.4 (CAT3)
DIO3: J4.4, R32.1
DIO3_PROT: R32.2, U1.9 (PD5(T1)), U8.1 (CAT1)
DIO4: J4.5, R33.1
DIO4_PROT: R33.2, U1.10 (PD6(AIN0)), U4.6 (CAT4)
DIO5: J4.6, R34.1
DIO5_PROT: R34.2, U1.11 (PD7(AIN1)), U4.4 (CAT3)
DIO6: J4.7, R35.1
DIO6_PROT: R35.2, U1.12 (PB0(ICP)), U4.3 (CAT2)
DIO7: J4.8, R36.1
DIO7_PROT: R36.2, U1.13 (PB1(OC1A)), U4.1 (CAT1); also elsewhere on the board
FGEN: FGEN.TP; also elsewhere on the board
GND: C1.2, C2.2, C3.2, C4.2, C5.2, C6.2, C7.2, C8.2, C9.2, D1.2 (-IN), FGEN_GND.TP, J1.6, J3.6, J3.8, J4.10, J4.11, J4.12, J5.6, R40.1, S1.1, S1.2 (1), U1.3 (GND), U1.5 (GND), U1.21 (AGND), U2.1 (ADJ/GND), U4.2 (COM_AN), U4.5 (COM_AN), U6.2 (GND), U6.2@1 (GND), U8.2 (COM_AN), U8.5 (COM_AN), U9.2 (COM_AN), U9.5 (COM_AN), U11.3; also elsewhere on the board
I_OUT: J5.5; also elsewhere on the board
I_SET: J5.3; also elsewhere on the board
LDAC: U1.14 (PB2(SS/OC1B)); also elsewhere on the board
MCU2USB: R48.1, R49.1, R50.1, U1.31 (PD1(TXD))
MISO: J1.1, U1.16 (PB4(MISO))
MOSI: J1.4, U1.15 (PB3(MOSI/OC2))
unnamed: R48.2, R49.2, R50.2, U11.1
unnamed: R46.2, R47.1, U3.8 (VBUS)
unnamed: R44.2, U10.1
unnamed: R39.2, U3.20 (RXD), U11.4
unnamed: R43.2, R44.1
unnamed: R43.1, U3.21 (TXD)
unnamed: TP-RXLED.TP, U3.13 (GPIO1/RXT)
unnamed: TP-TXLED.TP, U3.14 (GPIO0/TXT)
unnamed: R45.1, U3.9 (RSTB)
RESET: J1.5, R2.1, S1.3 (2), S1.4 (2), U1.29 (PC6(/RESET))
SCK: J1.3, U1.17 (PB5(SCK))
SCL: R4.1, U1.28 (PC5(ADC5/SCL)); also elsewhere on the board
SDA: R3.1, U1.27 (PC4(ADC4/SDA)); also elsewhere on the board
USB2MCU: R40.2, U1.30 (PD0(RXD)), U10.4
USB_GND: C12.2, C13.2, C14.2, J2.GND, J2.SHLD1 (SHIELD), J2.SHLD2 (SHIELD), R39.1, R46.1, TP-USBGND.TP, U3.2 (GND), U3.EP (GND_MIDDLE), U7.2 (COM_AN), U7.5 (COM_AN), U10.3
USB_VCC: C13.1, C14.1, R45.2, TP-USBVCC.TP, U3.5 (VI/O), U3.6 (VDD), U11.6
VBUS: C12.1, J2.VBUS, R47.2, U3.7 (VREGIN), U7.3 (CAT2)
VCC: C3.1, C6.1, J1.2, J6.3, R1.2, R2.2, R3.2, R4.2, U1.4 (VCC), U1.6 (VCC), U1.18 (AVCC), U2.2 (VOUT), U2.4 (VOUT), U10.6; also elsewhere on the board
V_OUT: J5.4; also elsewhere on the board
V_SET: J5.2; also elsewhere on the board

Notes on the sheet:
Mark Gilliland 2019
0.9

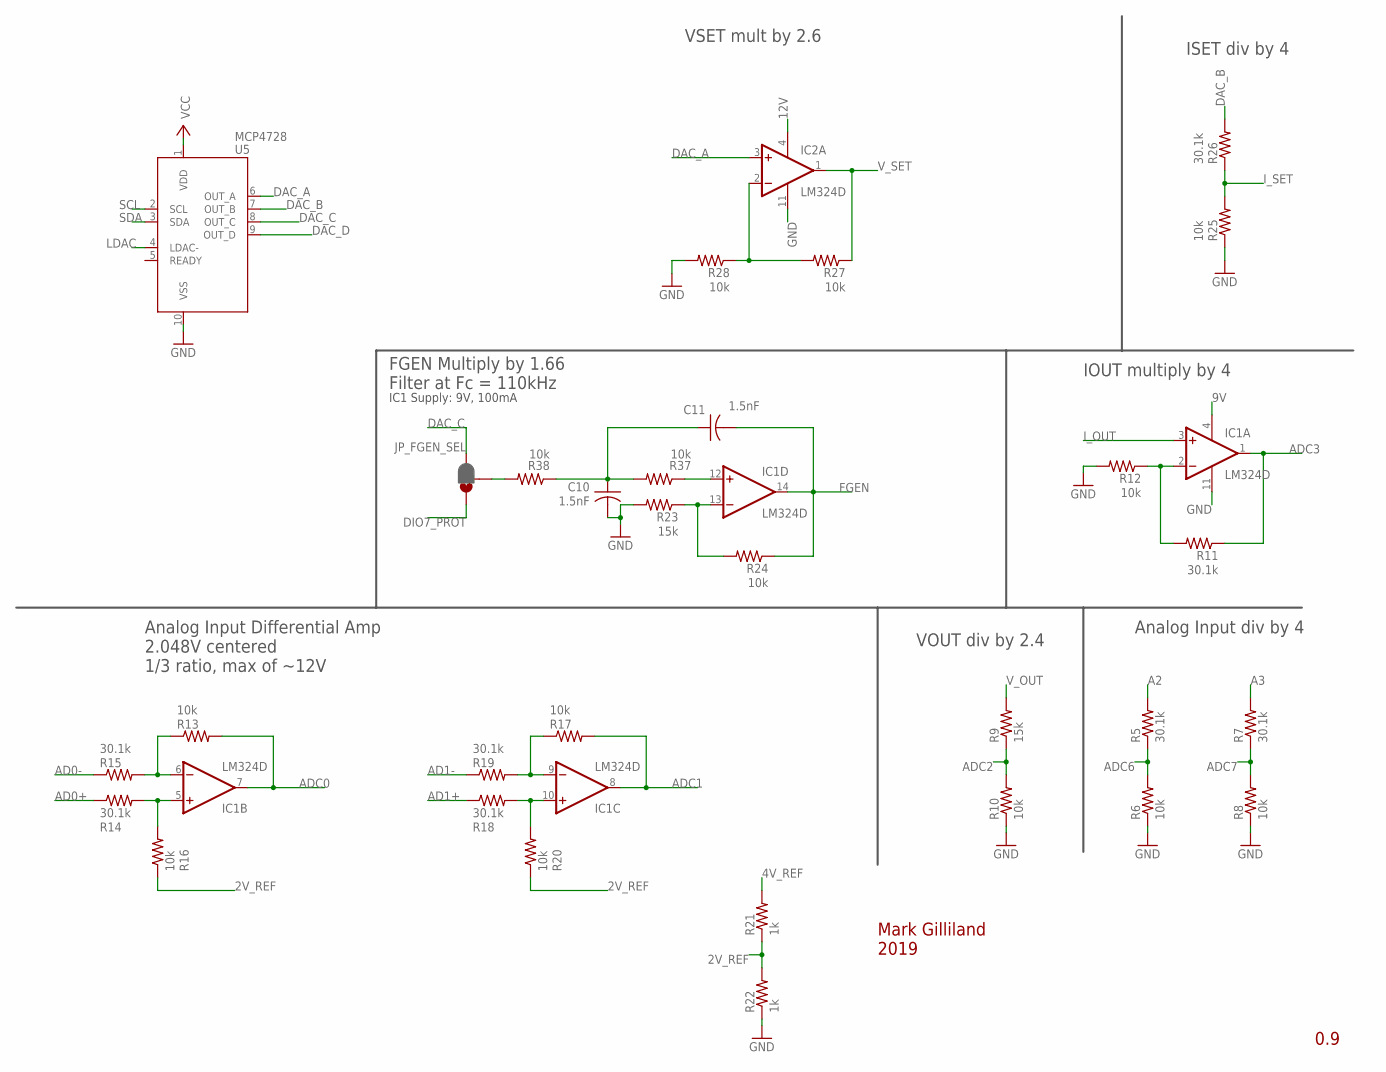
[picture p11: schematic microBackpack.sch, sheet 2]

Parts:
C10, C11: 1.5nF; C0805
IC1, IC2: LM324D; SO14
JP_FGEN_SEL: JUMPER-SMT_3_1-NC_PASTE_SILK; SMT-JUMPER_3_1-NC_PASTE_SILK
R5, R7, R11, R14, R15, R18, R19, R26: 30.1k; R0805
R6, R8, R10, R12, R13, R16, R17, R20, R24, R25, R27, R28, R37, R38: 10k; R0805
R9, R23: 15k; R0805
R21, R22: 1k; R0805
U5: MCP4728; MSOP10

Connections:
2V_REF: R16.1, R20.1, R21.1, R22.2; also elsewhere on the board
4V_REF: R21.2; also elsewhere on the board
9V: IC1.4 (V+); also elsewhere on the board
12V: IC2.4 (V+); also elsewhere on the board
A2: R5.2; also elsewhere on the board
A3: R7.2; also elsewhere on the board
AD0+: R14.1; also elsewhere on the board
AD0-: R15.1; also elsewhere on the board
AD1+: R18.1; also elsewhere on the board
AD1-: R19.1; also elsewhere on the board
ADC0: IC1.7 (OUT), R13.2; also elsewhere on the board
ADC1: IC1.8 (OUT), R17.2; also elsewhere on the board
ADC2: R9.1, R10.2; also elsewhere on the board
ADC3: IC1.1 (OUT), R11.1; also elsewhere on the board
ADC6: R5.1, R6.2; also elsewhere on the board
ADC7: R7.1, R8.2; also elsewhere on the board
DAC_A: IC2.3 (+IN), U5.6 (OUT_A)
DAC_B: R26.2, U5.7 (OUT_B)
DAC_C: JP_FGEN_SEL.3, U5.8 (OUT_C)
DAC_D: U5.9 (OUT_D)
DIO7_PROT: JP_FGEN_SEL.1; also elsewhere on the board
FGEN: C11.2, IC1.14 (OUT), R24.1; also elsewhere on the board
GND: C10.2, IC1.11 (V-), IC2.11 (V-), R6.1, R8.1, R10.1, R12.2, R22.1, R23.2, R25.1, R28.2, U5.10 (VSS); also elsewhere on the board
I_OUT: IC1.3 (+IN); also elsewhere on the board
I_SET: R25.2, R26.1; also elsewhere on the board
LDAC: U5.4 (LDAC-); also elsewhere on the board
unnamed: JP_FGEN_SEL.2, R38.2
unnamed: IC1.13 (-IN), R23.1, R24.2
unnamed: C10.1, C11.1, R37.2, R38.1
unnamed: IC1.2 (-IN), R11.2, R12.1
unnamed: IC1.6 (-IN), R13.1, R15.2
unnamed: IC1.5 (+IN), R14.2, R16.2
unnamed: IC2.2 (-IN), R27.2, R28.1
unnamed: IC1.12 (+IN), R37.1
unnamed: IC1.9 (-IN), R17.1, R19.2
unnamed: IC1.10 (+IN), R18.2, R20.2
SCL: U5.2 (SCL); also elsewhere on the board
SDA: U5.3 (SDA); also elsewhere on the board
VCC: U5.1 (VDD); also elsewhere on the board
V_OUT: R9.2; also elsewhere on the board
V_SET: IC2.1 (OUT), R27.1; also elsewhere on the board

Notes on the sheet:
Mark Gilliland 2019
0.9
VOUT div by 2.4
IOUT multiply by 4
Analog Input div by 4
Analog Input Differential Amp 2.048V centered 1/3 ratio, max of ~12V
FGEN Multiply by 1.66 Filter at Fc = 110kHz
IC1 Supply: 9V, 100mA
ISET div by 4
VSET mult by 2.6

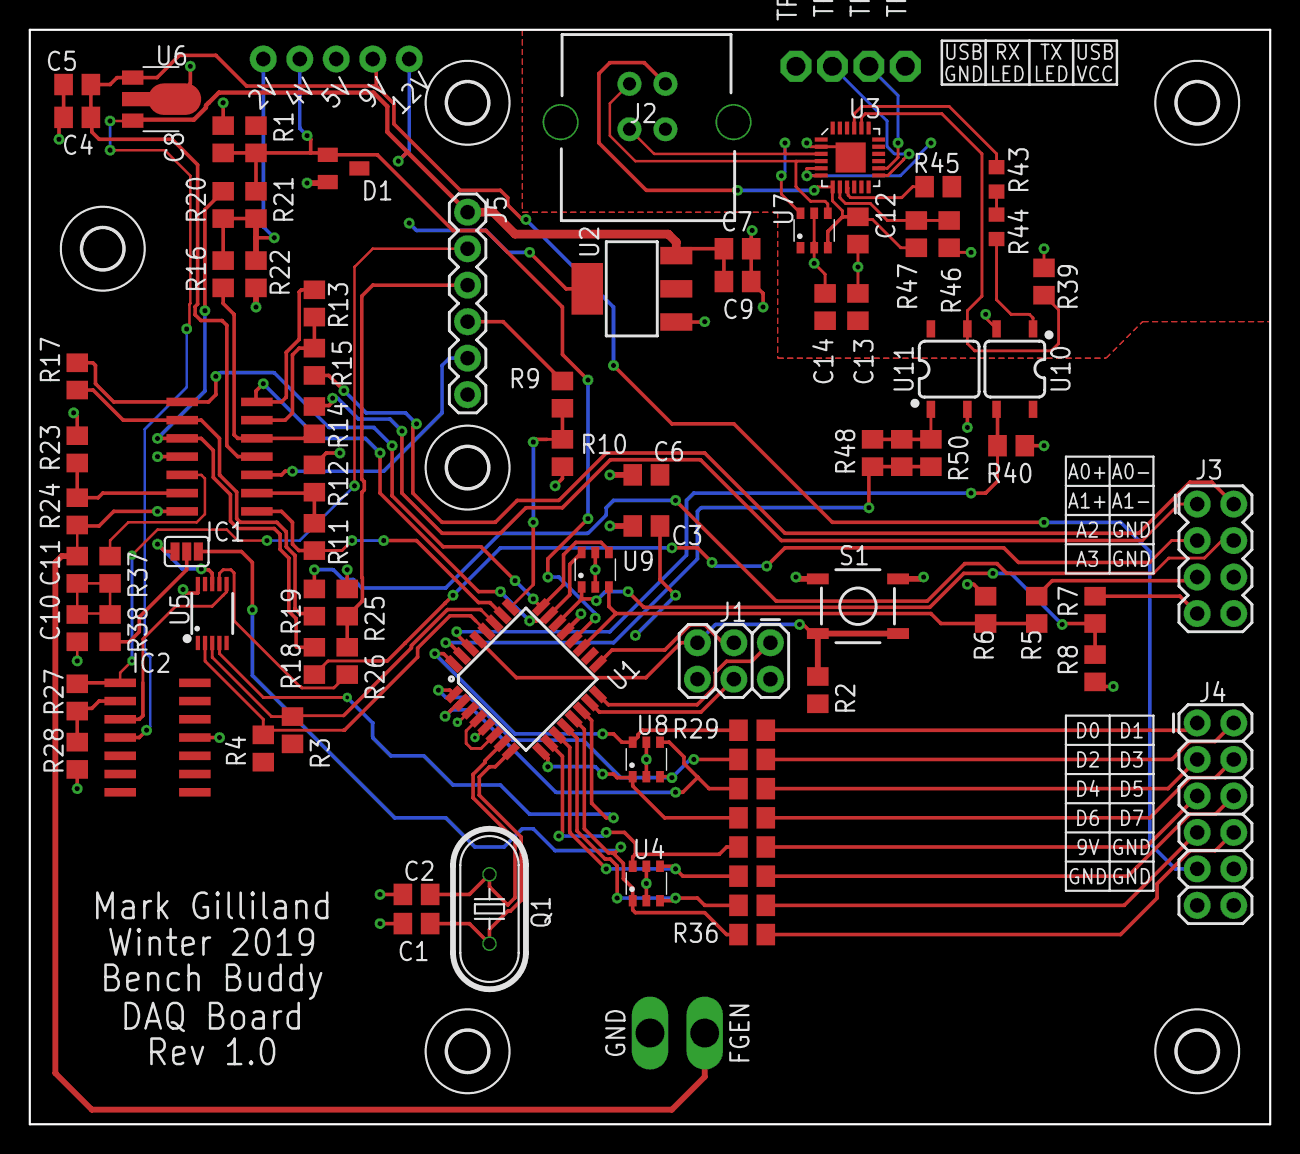
[picture p12: board microBackpack.brd from above]

Board: 2 copper layers, 86.4 x 76.2 mm, 97 parts (0 on the bottom side), 77 nets.
