MarkGilliland/benchBuddy/eagle/benchBuddy.brd

## EAGLE design eagle/benchBuddy.brd (2019-11-17)

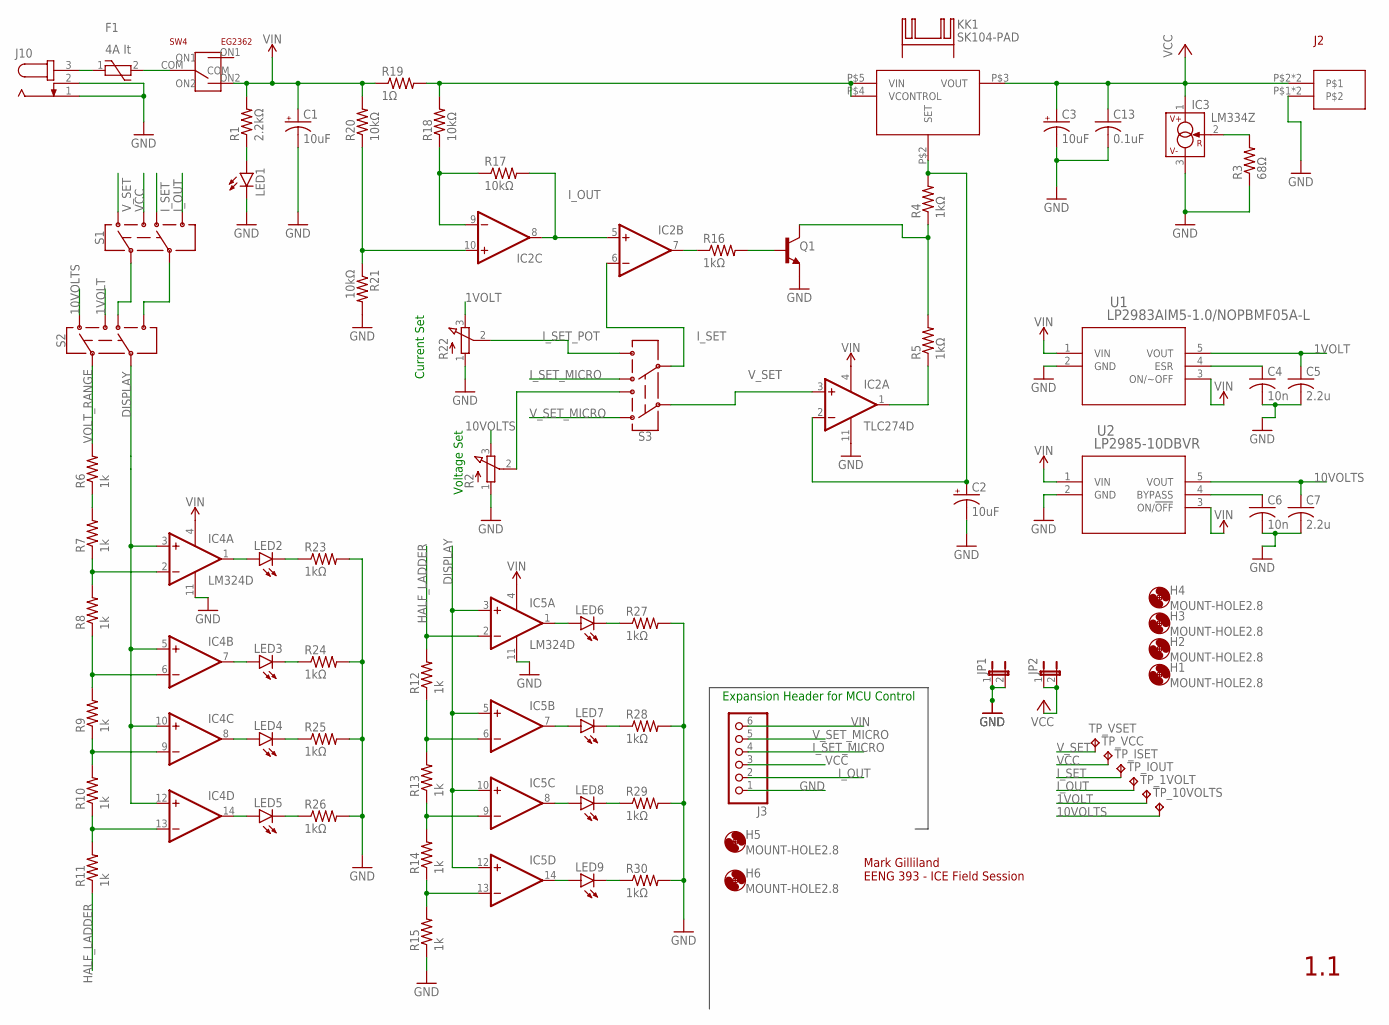
[picture p13: schematic benchBuddy.sch, sheet 1, PSU Schematic from Class]

Parts:
C1, C2, C3: 10uF; PANASONIC_B
C4, C6: 10n; C1206
C5, C7: 2.2u; C1206
C13: 0.1uF; C0805
F1: 4A It; LITTELFUSE_MINISMDC260F/12-2
H1, H2, H3, H4, H5, H6: MOUNT-HOLE2.8; 2,8
IC2: TLC274D; SO14
IC3: LM334Z; TO92
IC4, IC5: LM324D; SO14
J2: PHOENIX_SPRING_TERM_2POS; SPRING_TERM_2POS
J3: PINHD-1X6; 1X06
J10: JACK-PLUG0; SPC4077
JP1, JP2: JP1E; JP1
KK1: SK104-PAD
LED1, LED2, LED3, LED4, LED5, LED6, LED7, LED8, LED9: LEDCHIPLED_1206; CHIPLED_1206
Q1: 600mA/40V; SOT23-3
R1: 2.2kΩ; R1206
R2, R22: EVUF2A; EVUF
R3: 68Ω; R1206
R4, R5, R16, R23, R24, R25, R26, R27, R28, R29, R30: 1kΩ; R1206
R6, R7, R8, R9, R10, R11, R12, R13, R14, R15: 1k; R1206
R17, R18, R20, R21: 10kΩ; R1206
R19: 1Ω; 0411/15
S1, S2, S3: SWITCH-DPDT-SMD-AYZ0202; SWITCH_DPDT_SMD_AYZ0202
SW4: EG2362; SWITCH_EG2362-ND
TP_1VOLT, TP_10VOLTS: TPB1,27; B1,27
TP_IOUT: TPB1,27; B1,27
TP_ISET: TPB1,27; B1,27
TP_VCC: TPB1,27; B1,27
TP_VSET: TPB1,27; B1,27
U1: LP2983AIM5-1.0/NOPBMF05A-L; MF05A-L
U2: LP2985-10DBVR; DBV5
U$1: LT3080; TO-220-5R

Connections:
1VOLT: C5.1, R22.3 (E), S2.3, TP_1VOLT.TP, U1.5 (VOUT); also elsewhere on the board
10VOLTS: C7.1, R2.3 (E), S2.1, TP_10VOLTS.TP, U2.5 (VOUT); also elsewhere on the board
DISPLAY: IC4.3 (+IN), IC4.5 (+IN), IC4.10 (+IN), IC4.12 (+IN), IC5.3 (+IN), IC5.5 (+IN), IC5.10 (+IN), IC5.12 (+IN), S2.5
GND: C1.-, C2.-, C3.-, C4.2, C5.2, C6.2, C7.2, C13.2, IC2.11 (V-), IC3.3 (V-), IC4.11 (V-), IC5.11 (V-), J2.P$1, J2.P$3, J3.1, J10.1, J10.2, JP1.1, JP1.2, LED1.C, Q1.2 (E), R2.1 (A), R3.1, R15.1, R21.2, R22.1 (A), R23.2, R24.2, R25.2, R26.2, R27.2, R28.2, R29.2, R30.2, U1.2 (GND), U2.2 (GND); also elsewhere on the board
HALF_LADDER: IC5.2 (-IN), R11.1, R12.2
I_OUT: IC2.5 (+IN), IC2.8 (OUT), J3.2, R17.2, S1.6, TP_IOUT.TP; also elsewhere on the board
I_SET: IC2.6 (-IN), S1.4, S3.5, TP_ISET.TP; also elsewhere on the board
I_SET_MICRO: J3.4, S3.4
I_SET_POT: R22.2 (S), S3.6
unnamed: LED1.A, R1.1
unnamed: IC3.2 (R), R3.2
unnamed: F1.1, J10.3
unnamed: Q1.3 (C), R4.1, R5.2
unnamed: C2.+, IC2.2 (-IN), R4.2, U$1.P$2 (SET)
unnamed: R6.1, R7.2
unnamed: IC5.13 (-IN), R14.1, R15.2
unnamed: IC5.9 (-IN), R13.1, R14.2
unnamed: IC5.6 (-IN), R12.1, R13.2
unnamed: IC4.2 (-IN), R7.1, R8.2
unnamed: IC4.6 (-IN), R8.1, R9.2
unnamed: IC4.9 (-IN), R9.1, R10.2
unnamed: IC4.13 (-IN), R10.1, R11.2
unnamed: IC2.10 (+IN), R20.1, R21.1
unnamed: IC2.9 (-IN), R17.1, R18.1
unnamed: R18.2, R19.2, U$1.P$4 (VCONTROL), U$1.P$5 (VIN)
unnamed: C6.1, U2.4 (BYPASS)
unnamed: IC2.7 (OUT), R16.1
unnamed: Q1.1 (B), R16.2
unnamed: IC4.1 (OUT), LED2.A
unnamed: LED2.C, R23.1
unnamed: LED3.C, R24.1
unnamed: LED4.C, R25.1
unnamed: LED5.C, R26.1
unnamed: LED6.C, R27.1
unnamed: LED7.C, R28.1
unnamed: LED8.C, R29.1
unnamed: LED9.C, R30.1
unnamed: IC5.1 (OUT), LED6.A
unnamed: IC5.7 (OUT), LED7.A
unnamed: IC5.8 (OUT), LED8.A
unnamed: IC5.14 (OUT), LED9.A
unnamed: C4.1, U1.4 (ESR)
unnamed: S1.2, S2.4
unnamed: S1.5, S2.6
unnamed: F1.2, SW4.COM
unnamed: IC4.7 (OUT), LED3.A
unnamed: IC4.8 (OUT), LED4.A
unnamed: IC4.14 (OUT), LED5.A
ON1: SW4.ON1
VCC: C3.+, C13.1, IC3.1 (V+), J2.P$2, J2.P$4, J3.3, JP2.1, JP2.2, S1.3, TP_VCC.TP, U$1.P$3 (VOUT); also elsewhere on the board
VIN: C1.+, IC2.4 (V+), IC4.4 (V+), IC5.4 (V+), J3.6, R1.2, R19.1, R20.2, SW4.ON2, U1.1 (VIN), U1.3 (ON/~OFF), U2.1 (VIN), U2.3 (ON/!OFF); also elsewhere on the board
VOLT_RANGE: R6.2, S2.2
V_OUT: IC2.1 (OUT), R5.1
V_SET: IC2.3 (+IN), S1.1, S3.2, TP_VSET.TP; also elsewhere on the board
V_SET_MICRO: J3.5, S3.1
V_SET_POT: R2.2 (S), S3.3

Notes on the sheet:
Mark Gilliland EENG 393 - ICE Field Session
Voltage Set
Current Set
1.1
Expansion Header for MCU Control

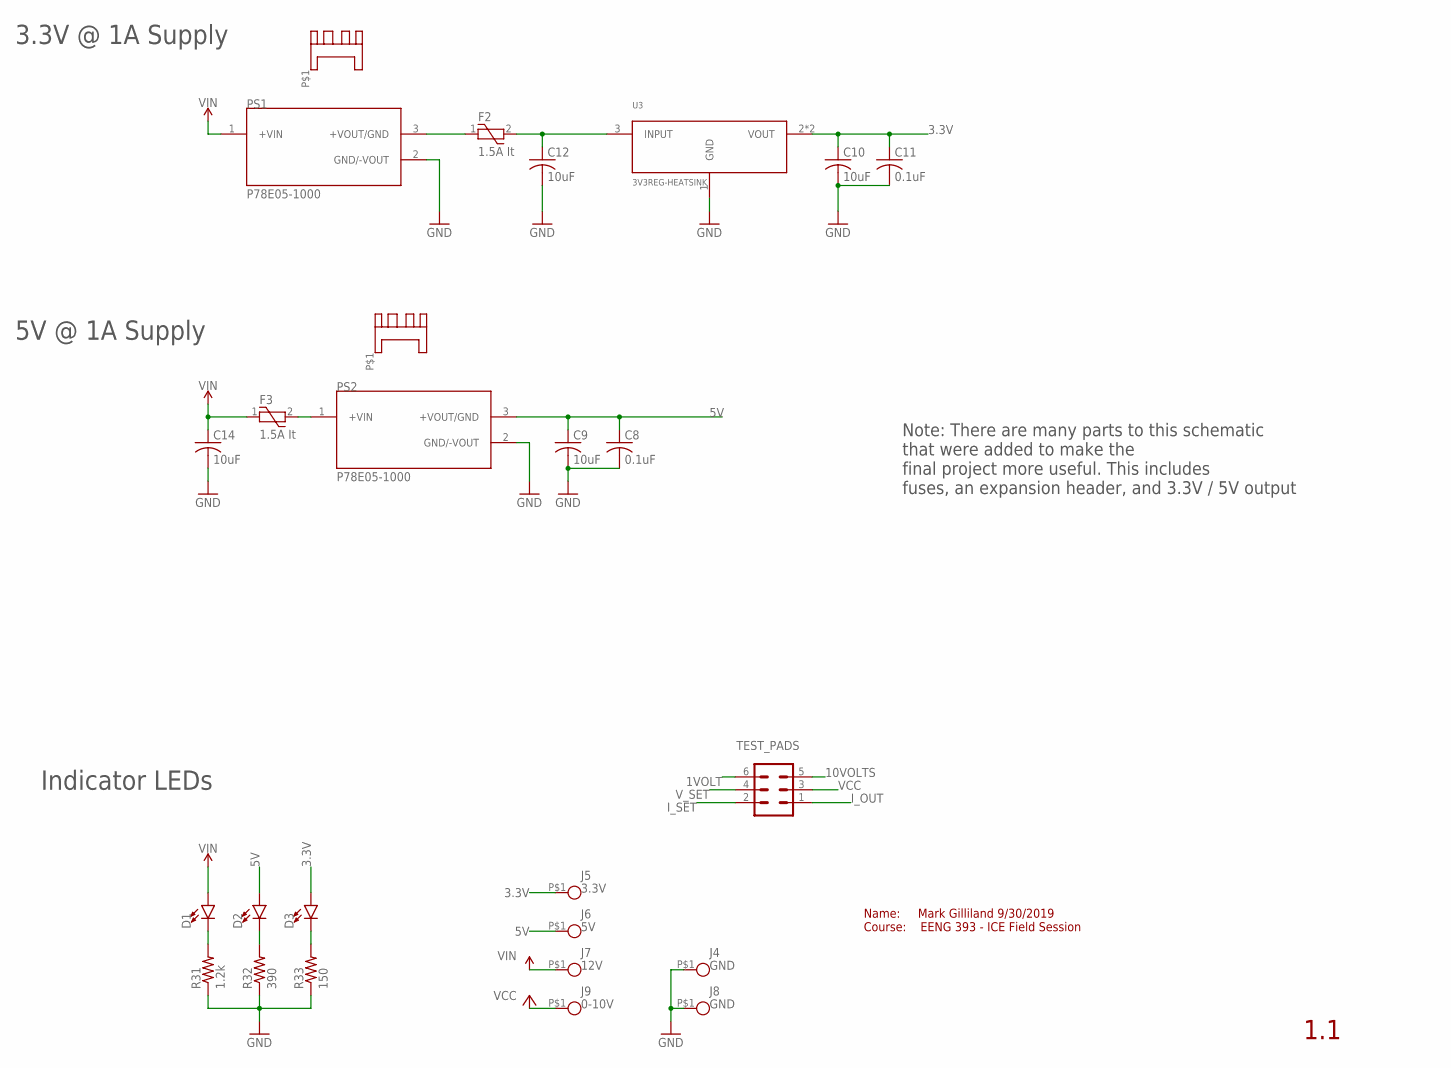
[picture p14: schematic benchBuddy.sch, sheet 2, Extra Power Supplies]

Parts:
C8, C11: 0.1uF; C0805
C9, C10, C12, C14: 10uF; C0805
D1, D2, D3: LED3MM; LED_3MM
F2, F3: 1.5A It; LITTELFUSE_MINISMDC260F/12-2
J4, J8: GND; FAT-PAD
J5: 3.3V; FAT-PAD
J6: 5V; FAT-PAD
J7: 12V; FAT-PAD
J9: 0-10V; FAT-PAD
PS1, PS2: P78E05-1000; CONV_P78E05-1000
R31: 1.2k; R1206
R32: 390; R1206
R33: 150; R1206
TEST_PADS: CONN_03X2NO_SILK; 2X3-NS
U3: 3V3REG-HEATSINK; SOT223-HS
U$2, U$3: HEATSINK_MINI

Connections:
1VOLT: TEST_PADS.6; also elsewhere on the board
3.3V: C10.1, C11.1, D3.A, J5.P$1, U3.2 (VOUT), U3.4 (VOUT)
5V: C8.1, C9.1, D2.A, J6.P$1, PS2.3 (+VOUT/GND)
10VOLTS: TEST_PADS.5; also elsewhere on the board
GND: C8.2, C9.2, C10.2, C11.2, C12.2, C14.2, J4.P$1, J8.P$1, PS1.2 (GND/-VOUT), PS2.2 (GND/-VOUT), R31.1, R32.1, R33.1, U3.1 (GND); also elsewhere on the board
I_OUT: TEST_PADS.1; also elsewhere on the board
I_SET: TEST_PADS.2; also elsewhere on the board
unnamed: F3.2, PS2.1 (+VIN)
unnamed: D1.K (C), R31.2
unnamed: D2.K (C), R32.2
unnamed: D3.K (C), R33.2
unnamed: F2.1, PS1.3 (+VOUT/GND)
unnamed: C12.1, F2.2, U3.3 (INPUT)
VCC: J9.P$1, TEST_PADS.3; also elsewhere on the board
VIN: C14.1, D1.A, F3.1, J7.P$1, PS1.1 (+VIN); also elsewhere on the board
V_SET: TEST_PADS.4; also elsewhere on the board

Notes on the sheet:
Name: Mark Gilliland 9/30/2019 Course: EENG 393 - ICE Field Session
3.3V @ 1A Supply
5V @ 1A Supply
Indicator LEDs
1.1
Note: There are many parts to this schematic that were added to make the final project more useful. This includes fuses, an expansion header, and 3.3V / 5V output

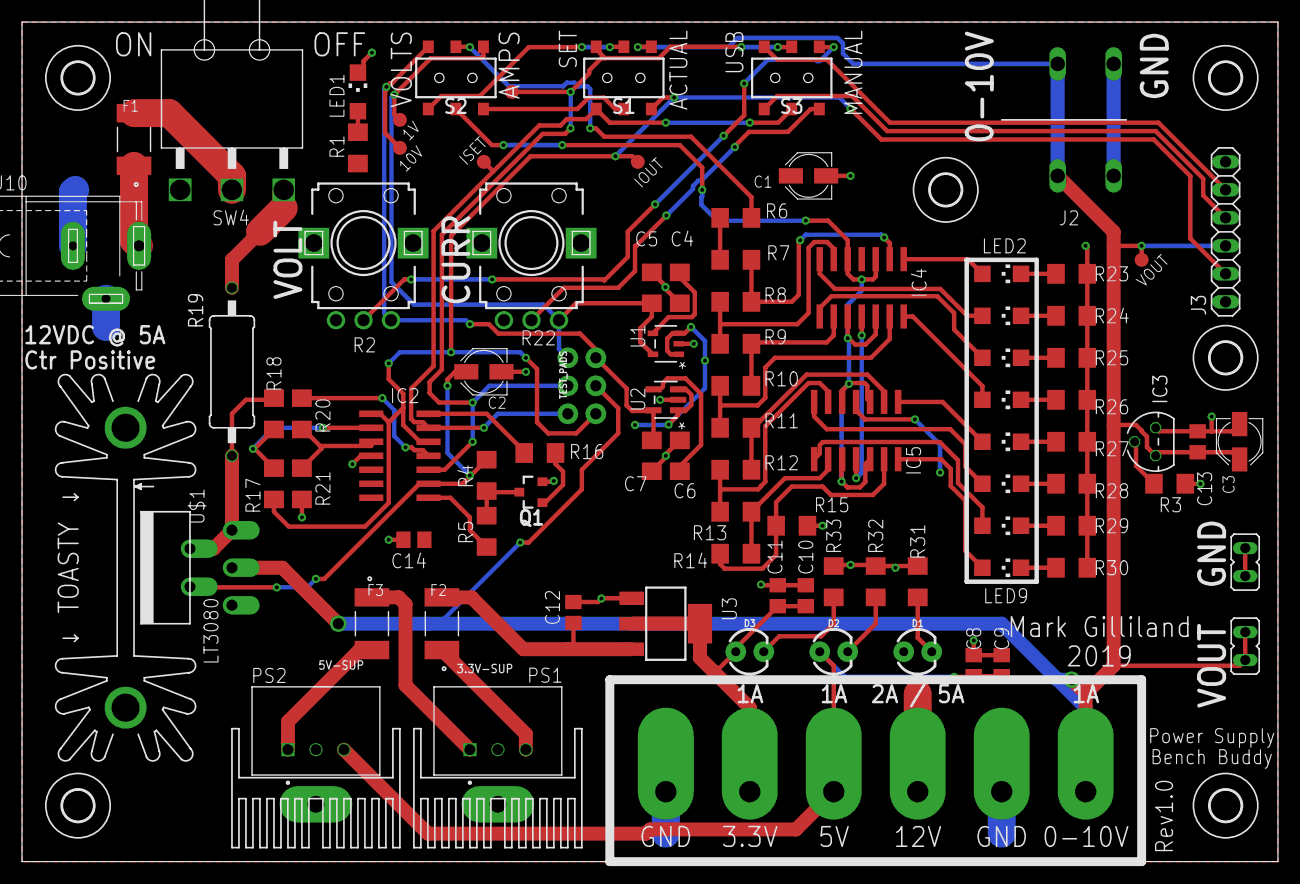
[picture p15: board benchBuddy.brd from above]

Board: 2 copper layers, 114.0 x 76.2 mm, 104 parts (0 on the bottom side), 63 nets.
