MarkGilliland/benchBuddy/(commit log)

2019-10-27 Added in brd and sch files, ready to start
    [BOM_Initial.xlsx, benchBuddy.brd, benchBuddy.sch]
2019-10-27 Added all parts. Schematic finished. Consider Rev 1.0
    [BOM_Initial.xlsx, benchBuddy.brd, benchBuddy.sch]
2019-10-27 Basic dimensions and mechanical layout of board
    [benchBuddy.brd, benchBuddy.sch]
2019-10-27 More detailed board layout. Began LED and VU layout
    [benchBuddy.brd, benchBuddy.sch]
2019-10-27 Most components in final position
    [benchBuddy.brd, benchBuddy.sch]
2019-10-27 VU meter routed
    [benchBuddy.brd]
2019-10-27 Added mini heatsinks for T220 Packages. Also more work on layout
    [benchBuddy.brd, benchBuddy.sch]
2019-10-28 Board mostly routed! Added heatsink 3.3V version
    [BOM_Initial.xlsx, benchBuddy.brd, benchBuddy.sch]
2019-10-28 Board fully routed. Added test header
    [benchBuddy.brd, benchBuddy.sch]
2019-10-28 Minimized board area to 4.5x3inches
    [benchBuddy.brd, benchBuddy.sch]
2019-10-28 Moved mounting holes slighly
    [benchBuddy.brd]
2019-10-28 Added ref-des and labels
    [benchBuddy.brd]
2019-10-28 Fixed minor airwire issues
    [benchBuddy.brd]
2019-10-28 Rotated 5VRegs so that Heatsink faces edge
    [benchBuddy.brd]
2019-10-28 Moved some labels
    [benchBuddy.brd]
2019-10-28 Added notes in schem
    [benchBuddy.sch]
2019-10-30 Filled out MCU Board BOM. Nearly complete BOM except Passives
    [BOM_Initial.xlsx]
2019-11-02 Added PDFs of each schematic
2019-11-02 added design rules. Gave 12V to expansion board rather than 10V. Fixed traces near 3.3V reg.
    [benchBuddy.brd, benchBuddy.sch]
2019-11-02 Added MG logo to bottom of board, as bRestrict
    [benchBuddy.brd]
2019-11-02 Started backpack board
    [BOM_Initial.xlsx, microBackpack.sch]
2019-11-02 Added components to library and schem
    [BOM_Initial.xlsx, microBackpack.brd, microBackpack.sch]
2019-11-02 Added more components
    [BOM_Initial.xlsx, microBackpack.brd, microBackpack.sch]
2019-11-02 Added analog circuitry. Most of schem is done. Still must do optoisolation and DIO protection
    [BOM_Initial.xlsx, microBackpack.brd, microBackpack.sch]
2019-11-02 Began board layout. Defined dimensions.
    [microBackpack.brd, microBackpack.sch]
2019-11-03 Began op amp placement. Very rough
    [microBackpack.brd]
2019-11-03 Fixed acid trap issues
    [benchBuddy.brd]
2019-11-04 Spec'd header part. Added DIO protection diodes and resistors. Significantly more routing done
    [BOM_Initial.xlsx, microBackpack.brd, microBackpack.sch]
2019-11-04 Rotated MCU to a 45
    [microBackpack.brd]
2019-11-04 More routing
    [microBackpack.brd]
2019-11-04 Moved sfuse so it does not block power jack
    [benchBuddy.brd]
2019-11-04 Added toasty. Rotated Regs for heatsink on part sub
    [benchBuddy.brd]
2019-11-04 added names
    [benchBuddy.brd]
2019-11-04 Added DRU file from silverCircuits. Also Changed logo on bottom layer so that FR4 is used for logo
    [benchBuddy.brd, benchBuddy.sch]
2019-11-04 Added revision label
    [benchBuddy.brd, benchBuddy.sch]
2019-11-04 Exported BOM from eagle. Spec'd resistors
    [BOM_Initial.xlsx]
2019-11-04 Power jack changed
    [benchBuddy.brd, benchBuddy.sch]
2019-11-04 Changed jack, again
    [benchBuddy.brd, benchBuddy.sch]
2019-11-04 Added gerber files
    [benchBuddy.brd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]
2019-11-04 Added bKeepout logo
    [benchBuddy.brd]
2019-11-04 New gerbers. Redid font
    [benchBuddy.brd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]
2019-11-04 Updated gerbers
    [gerber_job.gbrjob, profile.gbr, silkscreen_bottom.gbr, solderpaste_bottom.gbr, solderpaste_top.gbr]
2019-11-05 Added 2nd order filter to FGEN
    [microBackpack.brd, microBackpack.sch]
2019-11-05 Did stuff
    [microBackpack.brd]
2019-11-08 worked on BOM. Added values to LED resistors.
    [BOM_Initial.xlsx, benchBuddy.brd, benchBuddy.sch]
2019-11-09 Finished backpack BOM. Nearly ready to order.
    [BOM_Initial.xlsx]
2019-11-09 Determined final qtys for ordering
    [BOM_Initial.xlsx]
2019-11-09 Hopefully fixed MBP/PSB mixup
    [BOM_Initial.xlsx]
2019-11-09 Changed 10nF capacitor
    [BOM_Initial.xlsx]
2019-11-09 Shrunk board to 3x3'' size
    [microBackpack.brd]
2019-11-09 Added optoisolators to library. Wired up. Still need to finish USB power circuit.
    [benchBuddy.dxf, microBackpack.brd, microBackpack.sch]
2019-11-10 Added usb power. Switched optocouplers to active-high
    [BOM_Initial.xlsx, microBackpack.brd, microBackpack.sch]
2019-11-10 Routed more traces
    [BOM_Initial.xlsx, microBackpack.brd, microBackpack.sch]
2019-11-11 Moved headers and holes
    [microBackpack.brd, microBackpack.sch]
2019-11-11 Added stuff
    [benchBuddy.brd, microBackpack.brd]
2019-11-11 Added labels
    [benchBuddy.brd]
2019-11-12 Added lasercut information
    [benchBuddy.brd]
2019-11-12 Moved Bannana connectors. Added switch and LED labels
    [benchBuddy.brd]
2019-11-12 Added vector font, box around meter controls
    [benchBuddy.brd]
2019-11-17 Faceplate things
    [benchBuddy.brd, benchBuddy.dxf]
2019-11-18 BOM stuff
    [BOM_Initial.xlsx]
2019-11-18 Routed most traces
    [microBackpack.brd]
2019-11-18 Full layout complete. Added 9V to DIO header
    [microBackpack.brd, microBackpack.sch]
2019-11-18 Added test points and labels
    [microBackpack.brd, microBackpack.sch]
2019-11-18 Added attribution. Must add vertical USB port compatability.
    [microBackpack.brd]
2019-11-19 Added vertical USB. Ready to purchase
    [microBackpack.brd, microBackpack.sch]
2019-11-19 rerouted fgen and crystal as diff pair. Should be better for high frequency
    [microBackpack.brd, microBackpack.sch]
2019-11-19 Finished routing FGEN, added option for DIO DDS or DAC powered FGEN
    [microBackpack.brd, microBackpack.sch]
2019-11-19 Added gerbers
    [gerber_job.gbrjob]
2022-02-16 Added pdf of schematic, added images
